al3xand3w0lf/BeeTech/README.md

# BeeTech
 Beehive remote data monitoring

 Still a lot documentation to do:
 - part list, where to buy
 - change solid Works files to STEP, STL files
 - proper project description
 - proper manual
 - ...
