al3xand3w0lf/BeeTech/PROGRAMMING/Beetech ETH/ToDo.md

# To-Do’s

## ~~Recherchieren~~

## Hardware
- 3D-Design
  - ~~Teller~~
  - Gehäuse
- ~~Proto-Typ Aufbau~~

## Software
- ~~OLED ausprobieren~~
- ~~TEMP-Sensor ausprobieren~~
- ~~XFW ausprobieren~~
- ~~Waage konfiguieren~~
- ~~WLAN & InfluxDB einrichten~~
- ~~Code zusammenfügen~~
- Wake-Up funktion
- Daten an Server schicken

## Dokumentation
- Journal
- ~~Zeitplan~~
- GitHub
