al3xand3w0lf/BeeTech/PROGRAMMING/Beetech ETH/Dokumentation/links.md

# Links

- [Temp Sensor](https://www.analog.com/media/en/technical-documentation/data-sheets/ds18b20.pdf)
- [XFW-HX711](https://randomnerdtutorials.com/arduino-load-cell-hx711/)
- [ESP32 Feather V2](https://learn.adafruit.com/adafruit-esp32-feather-v2/overview)
