al3xand3w0lf/BeeTech/PROGRAMMING/Beetech ETH/Dokumentation/ProjektDoku.md

# IoT-Waage -- Projektdokumentation

## Inhaltsverzeichnis

1.  [Einleitung](#1-einleitung)
    -   [Projektauftrag](#11-projektauftrag)
    -   [Zielsetzung](#12-zielsetzung)
    -   [Rahmenbedingungen](#13-rahmenbedingungen)

2.  [Grundlagen & Theorie](#2-grundlagen--theorie)
    - [Wägezellen & HX711](#21-wägezellen--hx711)
    - [ESP32 Grundlagen](#22-esp32-grundlagen)
    - [DS18B20 Grundlagen](#23-ds18b20-grundlagen)
    - [OLED und I²C](#24-oled-und-i²c)
    - [IoT-Architektur (InfluxDB & Grafana)](#25-iot-architektur-influxdb--grafana)

3.  [Anforderungen](#3-anforderungen)
    - [Funktionale Anforderungen](#31-funktionale-anforderungen)
    - [Nicht-funktionale Anforderungen](#32-nicht-funktionale-anforderungen)
    - [Abnahmekriterien](#33-abnahmekriterien)
    - [Risiken & Herausforderungen](#34-risiken--herausforderungen)

4.  [Projektplanung](#4-projektplanung)
    - [Projektstruktur](#41-projektstruktur)
    - [Zeitplan](#42-zeitplan)
    - [Meilensteine](#43-meilensteine)
    - [Aufwandsschätzung](#44-aufwandsschätzung)
    - [Arbeitsmethode](#45-arbeitsmethode)

5.  [Mechanischer Aufbau](#5-mechanischer-aufbau)
    - [Komponenten & Materialien](#51-komponenten--materialien)
    - [Mechanisches Konzept](#52-mechanisches-konzept)
    - [CAD-Modelle](#53-cad-modelle)
    - [Belastungstests](#54-belastungstests)

6.  [Elektronischer Aufbau](#6-elektronischer-aufbau)
    - [Schaltplan](#61-schaltplan)
    - [Pinbelegung](#62-pinbelegung)
    - [Verkabelung](#63-verkabelung)
    - [Stromversorgung](#64-stromversorgung)

7.  [Softwareentwicklung](#7-softwareentwicklung)
    - [Softwarearchitektur](#71-softwarearchitektur)
    - [Kalibrierung](#72-kalibrierung)
    - [Temperaturmessung](#73-temperaturmessung)
    - [OLED-Ausgabe](#74-oled-ausgabe)
    - [WLAN & InfluxDB](#75-wlan--influxdb)
    - [Fehlerhandling](#76-fehlerhandling)

8.  [Inbetriebnahme & Tests](#8-inbetriebnahme--tests)
    - [Einzelkomponententests](#81-einzelkomponententests)
    - [Integrationstests](#82-integrationstests)
    - [Belastungstest](#83-belastungstest)
    - [Genauigkeitsanalyse](#84-genauigkeitsanalyse)

9.  [Ergebnisse & Visualisierung](#9-ergebnisse--visualisierung)
    - [Beispielmessungen](#91-beispielmessungen)
    - [Grafana Screenshots](#92-grafana-screenshots)
    - [Bewertung](#93-bewertung)

10. [Fazit](#10-fazit)
    - [Reflexion](#101-reflexion)
    - [Verbesserungsansätze](#102-verbesserungsansätze)
    - [Ausblick](#103-ausblick)

11. [Anhang](#11-anhang)
    - [Schaltpläne](#111-schaltpläne)
    - [CAD-Zeichnungen](#112-cad-zeichnungen)
    - [Stückliste](#113-stückliste)
    - [Quellcode](#114-quellcode)
    - [Datenblätter](#115-datenblätter)
    - [GitHub-Link](#116-github-link)

------------------------------------------------------------------------

# 1. Einleitung

## 1.1 Projektauftrag

Es soll eine elektronische IoT-Waage gebaut werden, welche periodisch
(alle 60 Sekunden) das Gewicht der Last in kg misst. Zusätzlich soll die
Temperatur der Last gemessen werden. Diese Messwerte sollen auf einem
OLED-Display dargestellt und gleichzeitig via WLAN in eine
InfluxDB-Datenbank gespeichert werden. Die Werte können via GrafanaDB
visualisiert werden. Alles wird auf GitHub veröffentlicht.

## 1.2 Zielsetzung

-   Zuverlässige Gewichtsmessung
-   Temperaturmessung
-   Senden der Daten an InfluxDB
-   Darstellung auf OLED

## 1.3 Rahmenbedingungen

-   Zeitraum: 120h
-   Arbeitsumgebung: Labor
-   Software: Arduino IDE
-   Komponenten: ESP32, HX711, DS18B20
-   Keine Tara-Funktion
-   Interner Gebrauch

------------------------------------------------------------------------

# 2. Grundlagen & Theorie

## 2.1 Wägezellen & HX711

Wägezellen basieren meist auf Dehnungsmessstreifen (DMS), die in einer Wheatstone-Brücke verschaltet sind. Wird die Zelle belastet, verändert sich der elektrische Widerstand der DMS minimal, wodurch eine sehr kleine Spannungsänderung entsteht. Diese Differenzspannung liegt typischerweise im Millivolt-Bereich und muss verstärkt und digitalisiert werden.

Der HX711 ist ein speziell für Wägezellen entwickelter 24-Bit-Analog-Digital-Wandler mit integriertem Verstärker. Er verstärkt die geringe Brückenspannung und wandelt sie in digitale Messwerte um, die seriell über zwei Pins (DOUT und SCK) ausgelesen werden können. Er ermöglicht eine hohe Messauflösung und eignet sich dadurch gut für Präzisionswaagen.

## 2.2 ESP32 Grundlagen

Der ESP32 ist ein Mikrocontroller mit integrierter WLAN- und Bluetooth-Funktionalität und eignet sich daher besonders für IoT-Anwendungen. Er verfügt über eine Vielzahl von GPIOs, unterstützt mehrere Kommunikationsprotokolle wie I²C, SPI, UART und OneWire und bietet ausreichend Rechenleistung für Sensorverarbeitung, Datenübertragung und interne Logik.

Für dieses Projekt übernimmt der ESP32 die Messwerterfassung, die Datenverarbeitung und die Kommunikation mit der Datenbank. Zudem steuert er Peripheriegeräte wie das OLED-Display und den Temperatursensor.

## 2.3 DS18B20 Grundlagen

Der DS18B20 ist ein digitaler Temperatursensor, der über das OneWire-Protokoll kommuniziert. Dieses benötigt nur eine einzige Datenleitung, über die sowohl die Kommunikation als auch die Identifikation erfolgt. Jede DS18B20-Einheit besitzt eine weltweit eindeutige 64-Bit-ID, wodurch mehrere Sensoren auf derselben Leitung betrieben werden können.

Der Sensor liefert Temperaturwerte zwischen −55 °C und +125 °C mit einer typischen Genauigkeit von ±0.5 °C im Bereich um 25 °C. Er kann normal mit drei Leitungen betrieben oder über „Parasite Power“ mit nur zwei Leitungen versorgt werden.

## 2.4 OLED und I²C

OLED-Displays bestehen aus selbstleuchtenden Pixeln und benötigen daher keine Hintergrundbeleuchtung. Typische Module im Embedded-Bereich, wie 128×64-Pixel-Displays, verwenden den I²C-Bus zur Kommunikation. I²C arbeitet mit zwei Leitungen (SDA und SCL) und ermöglicht das parallele Betreiben mehrerer Geräte am selben Bus, die jeweils über eine eindeutige Adresse angesprochen werden.

Im Projekt dient das OLED-Display zur visuellen Ausgabe der Gewichtswerte und Statusinformationen. Durch die geringe Leistungsaufnahme und die einfache Ansteuerung eignet es sich gut für kompakte IoT-Systeme.

## 2.5 IoT-Architektur (InfluxDB & Grafana)

Für die Speicherung und Visualisierung der Messdaten wird eine IoT-Architektur verwendet, die auf einer Zeitreihendatenbank basiert. Der ESP32 übermittelt die erfassten Werte über WLAN an eine InfluxDB-Instanz. InfluxDB ist optimiert für zeitbasierte Daten und erlaubt effizientes Speichern, Abfragen und Verarbeiten von Messreihen.

Zur Darstellung der Daten wird Grafana eingesetzt. Grafana ermöglicht das Erstellen interaktiver Dashboards, in denen Gewichtswerte, Temperaturverläufe und weitere Parameter übersichtlich visualisiert werden können. Die Kombination aus InfluxDB und Grafana bildet damit eine robuste Grundlage für die Analyse und Überwachung des Systems.

------------------------------------------------------------------------

# 3. Anforderungen

## 3.1 Funktionale Anforderungen

Die elektronische IoT-Waage muss folgende funktionale Anforderungen erfüllen:

- Die Waage misst das **Gesamtgewicht** einer aufgelegten Last mittels **vier Wägezellen**.
- Der **Messbereich** der Waage beträgt **0 bis 100 kg**.
- Die Gewichtsmessung erfolgt **periodisch alle 60 Sekunden**.
- Zusätzlich wird die **Temperatur der Last** mit einem digitalen Temperatursensor gemessen.
- Die aktuellen Messwerte (**Gewicht in kg, Temperatur in °C**) werden auf einem **OLED-Display** angezeigt.
- Die Messwerte werden **drahtlos über WLAN** an eine **InfluxDB-Datenbank** übertragen.
- Die gespeicherten Daten können in **Grafana** als Zeitreihe visualisiert werden.
- Die Waage verfügt über eine **Software-Kalibrierfunktion**.
- Die Messung bleibt auch bei **ungleicher Lastverteilung** funktionsfähig.
- Die Software läuft auf einem **ESP32-Mikrocontroller** und startet nach dem Einschalten automatisch.

## 3.2 Nicht-funktionale Anforderungen

Neben der reinen Funktionalität gelten folgende nicht-funktionale Anforderungen:

- Die Gewichtsanzeige ist **stabil** und zeigt im Ruhezustand keine stark schwankenden Werte.
- Die Messwerte werden **nachvollziehbar und reproduzierbar** erfasst.
- Die Software ist **strukturiert**, modular aufgebaut und ausreichend **kommentiert**.
- Alle Schaltpläne werden **übersichtlich und normgerecht** in **KiCad** erstellt.
- Mechanische Bauteile werden **sauber konstruiert** und **passgenau** gefertigt.
- Die Dokumentation ist **vollständig**, **verständlich** und **technisch korrekt**.
- Der gesamte Entwicklungsprozess wird mit **Git** versioniert.
- Die Messdatenübertragung ist **robust** gegenüber kurzen WLAN-Unterbrüchen.
- Die Stromversorgung erfolgt sicher über **USB 5 V**.
- Es werden ausschliesslich **frei verfügbare oder lizenzierte Bibliotheken** verwendet.

## 3.3 Abnahmekriterien

Das Projekt gilt als erfolgreich abgeschlossen, wenn folgende Kriterien erfüllt sind:

- Die Waage zeigt bei bekannten Prüfgewichten **plausible und reproduzierbare Messergebnisse**.
- Gewicht und Temperatur werden **korrekt auf dem OLED-Display** dargestellt.
- Messwerte werden **regelmässig in der InfluxDB gespeichert**.
- Die Messdaten sind in **Grafana** visualisierbar.
- Die Kalibrierung ist **dokumentiert** und nachvollziehbar.
- Der Schaltplan ist vollständig und entspricht dem realen Aufbau.
- Die mechanischen Bauteile erfüllen ihre Funktion ohne Beschädigung.
- Die Software lässt sich **kompilieren, flashen und starten**.
- Der gesamte Projektcode ist im **GitHub-Repository** vorhanden.
- Die Dokumentation deckt alle geforderten Kapitel ab.

## 3.4 Risiken & Herausforderungen

Während der Projektumsetzung bestehen folgende Risiken und Herausforderungen:

- **Ungleichmässige Lastverteilung** kann zu Messabweichungen führen.
- **Mechanische Toleranzen** im 3D-Druck können die Genauigkeit beeinflussen.
- **Temperaturdrift** der Wägezellen kann Messwerte verfälschen.
- **Elektrisches Rauschen** kann die Messung des HX711 beeinträchtigen.
- **Kalibrierung** mehrerer Wägezellen erfordert erhöhte Sorgfalt.
- **WLAN-Verbindungsprobleme** können zu Datenverlust führen.
- **Zeitmanagement** bei paralleler Hard- und Softwareentwicklung.
- **Fehlende Erfahrung** mit bestimmten Messverfahren kann Mehraufwand verursachen.

------------------------------------------------------------------------

# 4. Projektplanung

## 4.1 Projektstruktur

Um das Projekt übersichtlich und gut planbar zu machen, habe ich es in mehrere Hauptbereiche aufgeteilt. Jeder Bereich deckt einen bestimmten Teil der Arbeit ab, und zusammen ergeben sie das komplette IoT-Waagen-System. Durch diese Struktur konnte ich Schritt für Schritt arbeiten, ohne den Überblick zu verlieren.

Die Projektstruktur besteht aus folgenden Teilen:

- **Mechanik:**  
  Aufbau der Waage mit vier Wägezellen und zwei Metallplatten. Dazu gehört das Positionieren der Elemente, die Stabilität der Konstruktion und das Erstellen von CAD-Modellen in SolidWorks.

- **Elektronik:**  
  Verdrahten und Anschliessen aller Komponenten (ESP32, HX711, DS18B20, OLED). Auch die Pinbelegung, Stromversorgung und der Schaltplan in KiCad gehören in diesen Bereich.

- **Software:**  
  Programmierung des ESP32 mit der Arduino IDE. Dazu zählen das Auslesen der Wägezellen, die Kalibrierung, die Temperaturmessung, die Anzeige auf dem OLED und das Senden der Daten an die InfluxDB.

- **Tests & Kalibrierung:**  
  Überprüfen der einzelnen Module, Belastungstests, Genauigkeitsmessungen und die Kalibrierung der Waage mit Referenzgewichten. Hier wird geschaut, ob die Waage zuverlässig arbeitet.

- **Datenanbindung (InfluxDB & Grafana):**  
  Einrichten der Verbindung zur Datenbank, Testen der Übertragung und Kontrolle der Messwerte in Grafana. So wird sichtbar, wie sich die Werte über die Zeit verändern.

- **Dokumentation & Journal:**  
  Schreiben der Projektunterlagen, Festhalten des täglichen Arbeitsfortschritts im Journal und Erstellen des GitHub-Repositories. Dadurch bleibt das Projekt vollständig nachvollziehbar.

Diese Struktur hilft dabei, das Projekt sauber zu gliedern und jeden Teil separat behandeln zu können. Wenn irgendwo ein Problem auftaucht, kann ich dank dieser Aufteilung schnell erkennen, in welchem Bereich es entsteht und wie ich es am besten angehe.

## 4.2 Zeitplan

## 4.3 Meilensteine

## 4.4 Aufwandsschätzung

## 4.5 Arbeitsmethode

Für dieses Projekt habe ich versucht, möglichst strukturiert und Schritt für Schritt zu arbeiten. Damit ich den Überblick behalte, habe ich das Projekt in mehrere Bereiche eingeteilt: Mechanik, Elektronik, Software, Tests und Dokumentation. So konnte ich mich immer auf einen Teil konzentrieren, ohne alles gleichzeitig machen zu müssen.

Ich habe ein GitHub-Repository erstellt, in dem ich meinen Code und wichtige Dateien gespeichert habe. Dadurch konnte ich Änderungen sauber festhalten und jederzeit auf ältere Versionen zurückgreifen. Für den Schaltplan habe ich KiCad verwendet und die mechanischen Teile mit SolidWorks modelliert. Programmiert wurde alles in der Arduino IDE, weil ich damit am schnellsten vorankomme.

Beim Arbeiten bin ich nach dem Prinzip vorgegangen, zuerst jede Komponente einzeln zu testen. Also z. B. zuerst den HX711, dann den Temperatursensor, dann das OLED. Wenn etwas nicht funktioniert hat, konnte ich so viel einfacher herausfinden, wo der Fehler liegt. Erst als alle Module einzeln liefen, habe ich sie zusammengebaut und weiter getestet.

Während des gesamten Projekts habe ich ein tägliches Journal geführt, in dem ich festgehalten habe, was ich gemacht habe, welche Probleme aufgetaucht sind und wie ich sie gelöst habe. Das hilft nicht nur für die Doku, sondern auch, um später nachzuvollziehen, warum ich etwas auf eine bestimmte Art gemacht habe.

Die Dokumentation habe ich parallel zum Projekt geschrieben und am Schluss nochmals alles sauber zusammengestellt.

Diese Arbeitsweise hat mir geholfen, das Projekt klar zu strukturieren und Probleme schnell zu erkennen und zu lösen.

------------------------------------------------------------------------

# 5. Mechanischer Aufbau

## 5.1 Komponenten & Materialien

## 5.2 Mechanisches Konzept

## 5.3 CAD-Modelle

## 5.4 Belastungstests

------------------------------------------------------------------------

# 6. Elektronischer Aufbau

## 6.1 Schaltplan

## 6.2 Pinbelegung

## 6.3 Verkabelung

## 6.4 Stromversorgung

------------------------------------------------------------------------

# 7. Softwareentwicklung

## 7.1 Softwarearchitektur

## 7.2 Kalibrierung

## 7.3 Temperaturmessung

## 7.4 OLED-Ausgabe

## 7.5 WLAN & InfluxDB

## 7.6 Fehlerhandling

------------------------------------------------------------------------

# 8. Inbetriebnahme & Tests

## 8.1 Einzelkomponententests

## 8.2 Integrationstests

## 8.3 Belastungstest

## 8.4 Genauigkeitsanalyse

------------------------------------------------------------------------

# 9. Ergebnisse & Visualisierung

## 9.1 Beispielmessungen

## 9.2 Grafana Screenshots

## 9.3 Bewertung

------------------------------------------------------------------------

# 10. Fazit

## 10.1 Reflexion

## 10.2 Verbesserungsansätze

## 10.3 Ausblick

------------------------------------------------------------------------

# 11. Anhang

## 11.1 Schaltpläne

## 11.2 CAD-Zeichnungen

## 11.3 Stückliste

## 11.4 Quellcode

## 11.5 Datenblätter

## 11.6 GitHub-Link
