al3xand3w0lf/BeeTech/ELECTRONIC_CAD/voltageLevelsNanoBoard.docx

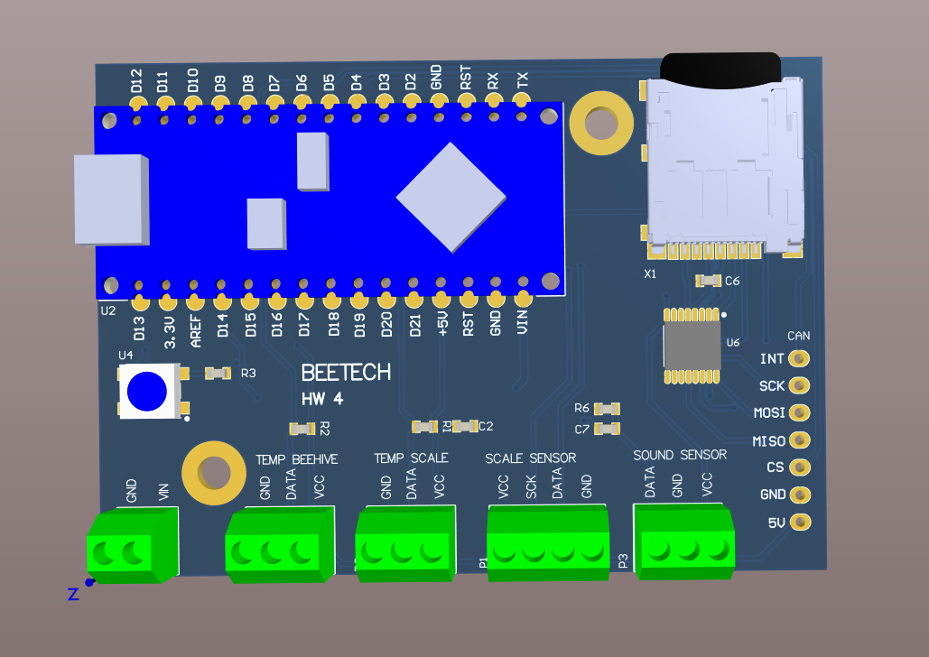
[picture p3: figure]

+12V

+5v

+5v

+5v

+5v

+5v

+3.3v

+5v
