al3xand3w0lf/BeeTech/PROGRAMMING/Beetech ETH/Dokumentation/zeitplan_tabelle.md

# Zeitplan

## Meilensteine

| Aufgabe | Geschätzte Zeit (Stunden) | Ist Zeit (Stunden) | Bemerkungen | Soll Beendet | Ist Beendet |
|---|---|---|---|---|---|
| Recherche & Verständnis | 6–10 |  8 | Verstehen von HX711, ESP32, OneWire, OLED | 3.12 | 3.12. |
| Projektplanung | 3–5 |  3 | Grundstruktur & Meilensteine erstellen | 3.12 | 3.12. |
| CAD-Design (SolidWorks + 3D-Druck) | 10–15 | | Modellierung + Druck + Anpassungen | 16.1 | |
| Schaltplan (KiCad) | 6–10 | | Sauberer Schaltplan mit Labels | 19.12 | |
| Stückliste (BOM) | 2–3 | | Bauteile, Preise, Bestellnummern | 19.12 | |
| Hardware-Aufbau | 8–12 | | Mechanischer & elektrischer Aufbau | 9.12 | |
| Software Basis-Funktionalität | 8–12 | | Sensoren + Display ansteuern | 12.12 | |
| Protokollanalyse | 4–6 | | I2C analysieren, Screenshots | 14.12 | |
| Kalibrierung der Waage | 3–4 | | Gewichte testen & Faktoren bestimmen | 12.1 | |
| WLAN + InfluxDB-Integration | 6–10 | | Datenbank-Anbindung & Senden | 12.12 | |
| Dokumentation (Word) | 15–20 | | Screenshots, Erklärungen, Struktur | 23.1 | |
| GitHub-Aufbereitung | 2–4 | | Repository aufräumen, README | 25.1 | |

---

## Soll

| Tag | KW49 | KW50 | KW51 | KW2 | KW3 | KW4 |
|---|---|---|---|---|---|---|
| Montag | Recherche | Teller Designen | WLAN InfluxDB  | Doku | 3D-Design  | Testen  |
| Mittwoch  | GitHub erweitern | Waage konfigurieren | Schematic | x | 3D-Design  | Doku |
| Donnerstag| OLED Code schreiben| Doku | Schematic | Doku | 3D-Design  | Doku |
| Freitag | Temp testen | Prototyp Aufbau | Schematic | Doku | Testen | Doku |

---

## Ist

| Tag | KW49 | KW50 | KW51 | KW2 | KW3 | KW4 |
|---|---|---|---|-----|-----|-----|
| Montag | Rechechiert | Teller am Designen | | | | |
| Mittwoch  | GitHub erweitert | Doku weitergeschreiben | | | | |
| Donnerstag| OLED Code geschrieben | Teller Designet | | | | |
| Freitag | Temp getestet | Waage am Konfiguiren | | | | |
