al3xand3w0lf/BeeTech/ELECTRONIC_CAD/ECAD/Scale Board.docx

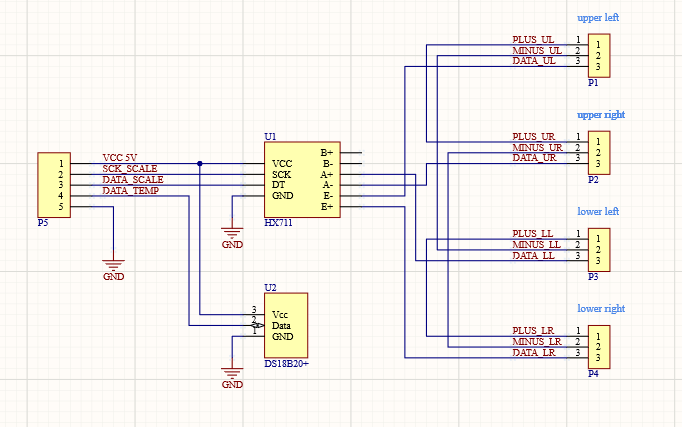
[picture p4: figure]
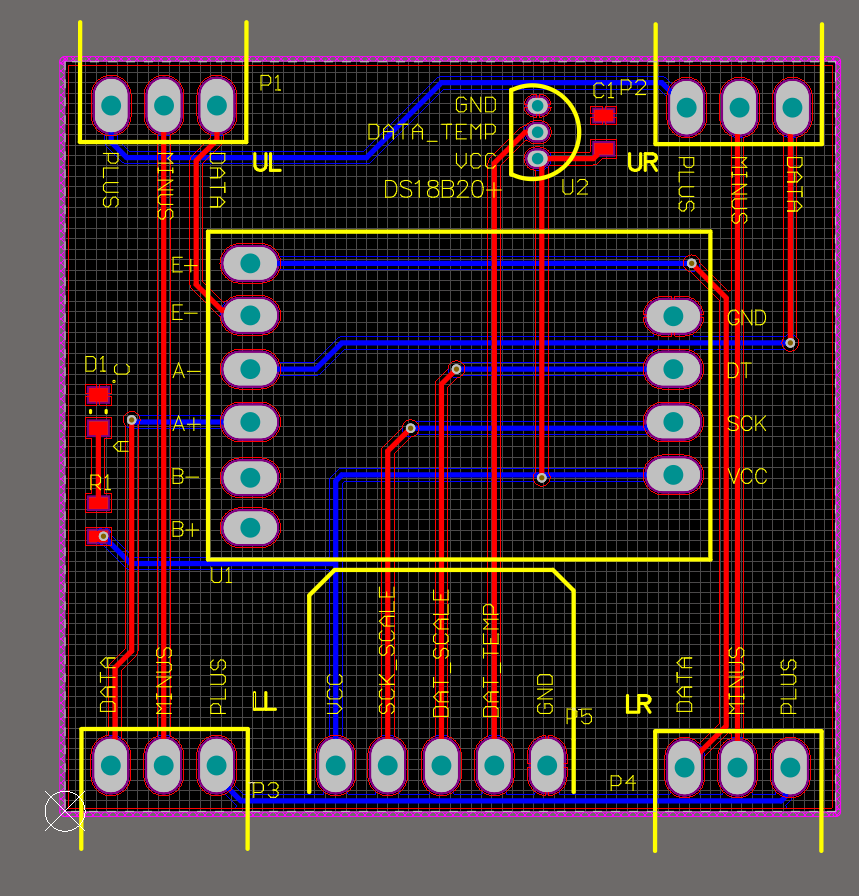
[picture p5: figure]
