al3xand3w0lf/BeeTech/PROGRAMMING/Beetech V1/BeeHive_MKR1400_Board/canScematic.pdf

X_
x

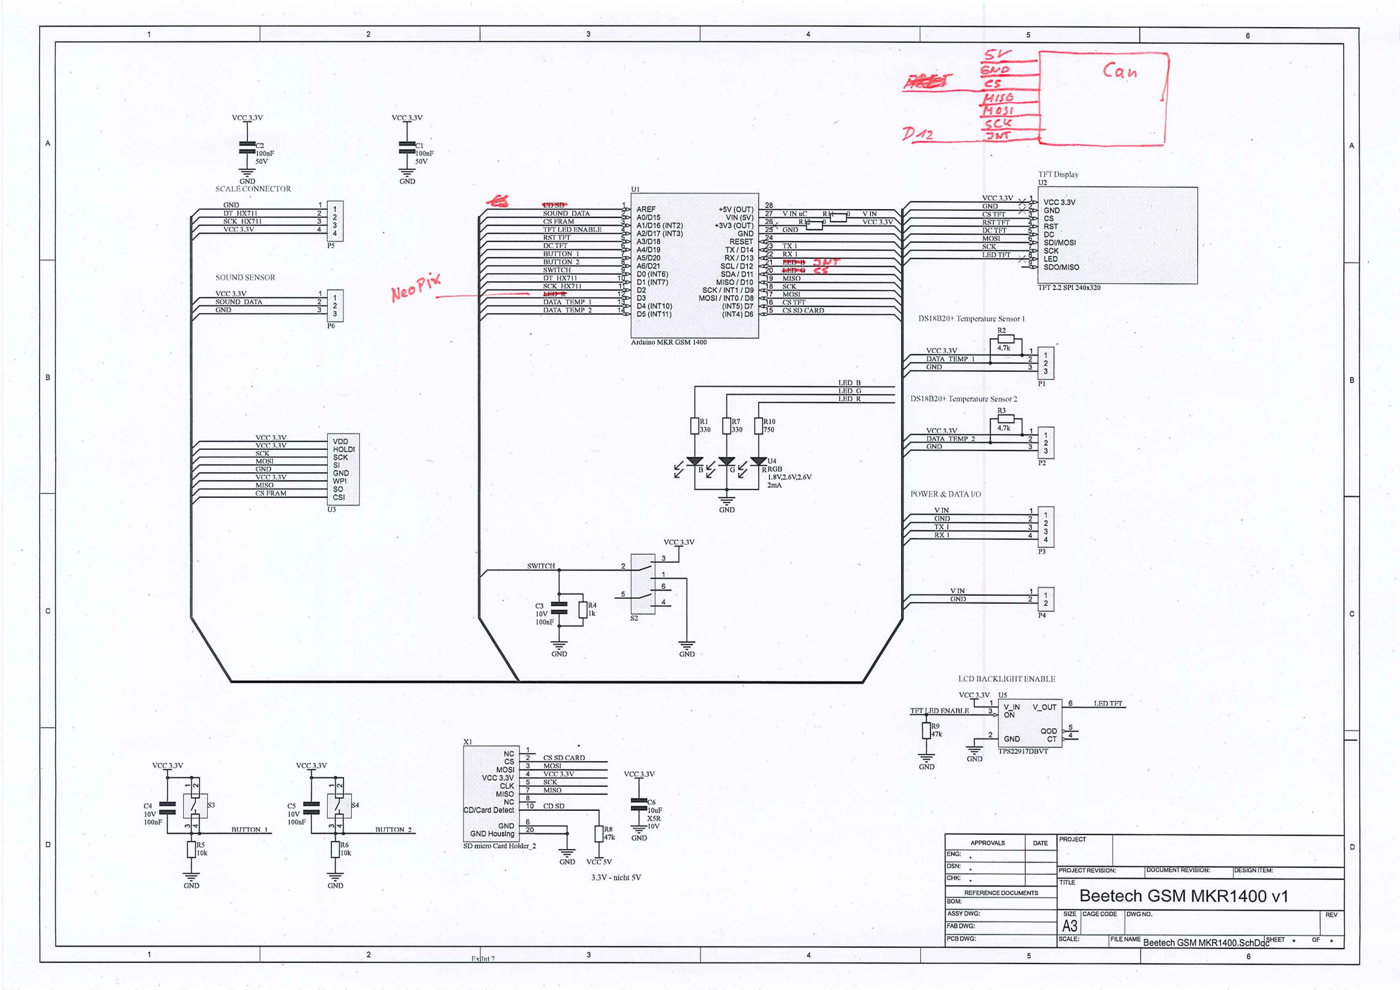
[picture p6: page 1]

VCC 3.3V

### GND

DT HX711
SCK HX71I
VC'C 3.3V

3:

MH'NDSl'NSOR

VCC 3.3V
SOUND DATA
GND

1
2
3

### VDD HOLDI SCK

VCC -•UV

"L

'lOOn
50V

-<^

^'^
^"•:

SOUND DATA

TFl'LKD UNABLE

DATA TKMK 1
DATA •t'KMl1 ;

# ^iki

^

TH- Display
U2

### +5V (OUT) VIN (5V) +3V3 (OUT) GND

# JSSET [^

### TX/D14 h^ RX/D13 SCL/012 SDA/D11 MISO/D10 SCK/INT1/D9 MOSI/INTO/D8 (1NT5) D7 (INT4) D6

Arduiiio MKR GSM 1400

^

^

### iiii nit7 riRio

|330 | |330 | |750

### ttRQB

1.8V.2.6V.2.GV
2mA

VCC 3.3V

### GND

os

### RST

DC

### SDl/MOSI SCK LED SDO/MISO

TFT 2.2 SPI 240x320

VCC.3
DATA
ON D

.3V
TEMP 1
4.7k | 1
| _2_ _3

vmPATA_
JV
TF.MP 2

4,7k 1

-2.
3

### POWl-^ADATM/O

V IN
OND

### TXI

RXI

1

_2.
3'
4

NC

### MOSI

VCC 3.3V

### CLK M ISO

NC

### 30/Card Detect GND GND Housing

>D micro Card He

1T3

4
5
7

10

6

-20.
icr 2

CS SD CARD
MOS1
vrr 33V
SCK
Ml SO

CDSD

### IRB

j47k

VCC 3.3V
X.

'10uF
X5R
—i—inv

GND VCC 5V

3,3V - n

l.l.'DI.IAC-t;

VCC 3,3V
1
TFT^RD ENABLE -3^
]1>9

^ ^GND

.id n

15

### V IN

ON

### GND

-!1S229

'iwjiu-:

V_OUT

### QOD

CT
17DBVT

6 LHDTFT

3:

REFERENCE DOCUMEhfTS

IECT REVISION; —I bocUuEN I teUBK»k —U-alGrilltM:

# Beetech GSM MKR1400 v1

A3

### ISCALE I FILE N«UE g^jg^ QSM MKR1400.SchDcigHEET
