al3xand3w0lf/BeeTech/PROGRAMMING/Beetech V1/BeeHive_NanoEvery_Board/can_scematic.pdf

# ZA ^8A3 oue|\| qoeieeg

T^~

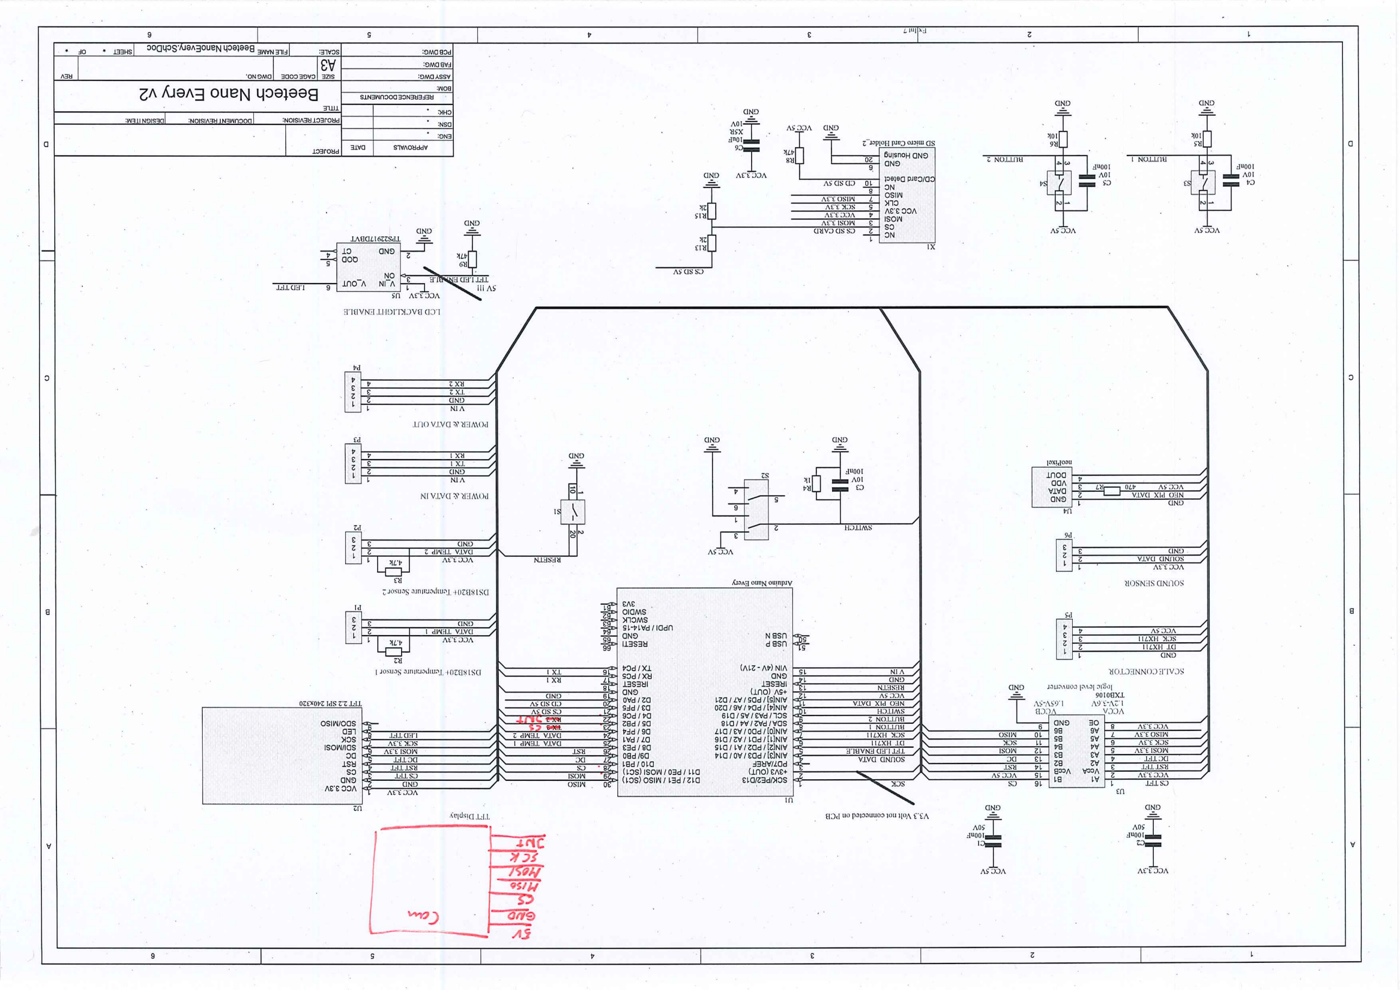
[picture p7: page 1]

A3y

„ . ^Hsl °°a^S''U8A30UENq3S)93g3n,,3,,

•ONOMOl 3aD333V3

:3~]VOS
£Vazis

31111
miiffins-iai :No|R|ft3yiN3nnnog| _:NOisiA3yi33royd

isaroyd

:3Ma93d
:OMQSVd
:OMQASSV

•WOQ
SlN3fin30a 33N3y3d3y

31VQ

:3N3
SIWOUddV

fr
s

jjiua-i 9

lAya^t
10

### aoo

ino-A

6KScL

### ONS

### NFA

if

UNO

^a'n

I
An- JJA

wr
6t!l

i-d ua-i IAI

### Ill AS

•rKiVN-u.nnnxmKL

t?

_E_
3_
I.

ZXtl
ZX.1.

-UM'J..
N1A

ocptoM: ids r^ iji

### osiwoas

031

### xos iscm/ias

oa

### isa

S3
ON9
A£'£ 03A

K)V.LVCIVil;lA\l)d
3: 3:
x

1 XII
1 Xl
UND

Nlv,i.V(iyy;iA\oj

### L-iTti.^'wi:

\-_?-_dMai_viyy_

•i^'.y -~

nsx
d"OIi

QND AE't^DA 1.

it

AS" D3A QW
<

D

M-aticu

AE-EnSltM
AE'E ?tJS
AFE J.JA
AE't- IKCm
uyvj us S3

t "F

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
OH pjco ojaiui as
BufsnoH ON9
QN9

pei&a pjeo/ac)
ON

### osm

>no
AC'E 03A

### ISO N

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
d"OOI
AOI
£3

HJIIAU;

toAg ounft oumpJV

### EAE OIQMS

X-IOAAS
si-nvd/iadn

### ONS iiassy

### >Od/Xi sod/xu iasaai QNS ovd / za Sdd / EQ 90d / ra zad / sa Md/9Q

i.vd / za
£3d / 9G

### OSd ,60

LBd/01.0

### U3S)lSOW/03d/Ll,a (l.OS)OSIM/l3d/21.a

(AI-Z-A^NIA

### QNS lasayi dno) AS+ iza/zv/sad/tslNiv oza/9v/trad/[tr]Niv 6i.a/sv/evd/i3s sia/mzvd/vas ZLa/ev/oad/toNv 9La/W/l.ad/[L]NIV SLQ/LV/Sad/klNIV Ha/ov/ead/t&lNiv jayvuad dno) EAe+ ei.a/zadfflos

V1VCI XIJ OdN

a'lyvM-dua'ii^i
V1VQ QNTIOS
ff-

### inoa aoA viva

QN3

v
E H

z_
L

0^t' A^J^A
V.I.VC1 Xiti UHN
UNO

Al;'E33A

tIOSN.-t^i CIMllOS

e
~z

I.

Ai DJA
IUXH ^js

IUXH 1U ._,_^
QMD

OKIW
^QS;
1SOM
oa
ISll
Ai JJA

^_
_OJ
Sl
£'
fl
51

mt,I.JHNis[(U:-l

90IOBXJL
A')t-.\:ll
,.UA
9

i.

_9_
fr
E
z

Ai:'EO:lA
At'EOyiM
A'i'i •XJS
Ai'i [SON

Idl'JQ .._.,_..,
.L-I-LIS^
M'i DJA

\w
ooii

\os

ooti I
