al3xand3w0lf/BeeTech/PROGRAMMING/Beetech V2/Screenshot 2026-03-02 213556.png

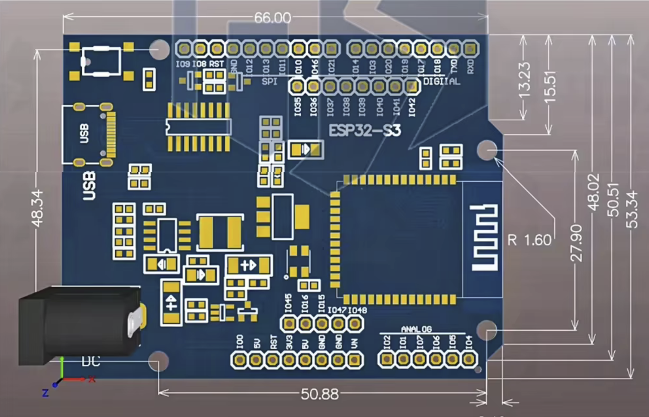
PROGRAMMING/Beetech V2/Screenshot 2026-03-02 213556.png
