al3xand3w0lf/BeeTech/ELECTRONIC_CAD/ECAD/Beetech Metro Shield 1.2/MCAD/PCB.STEP

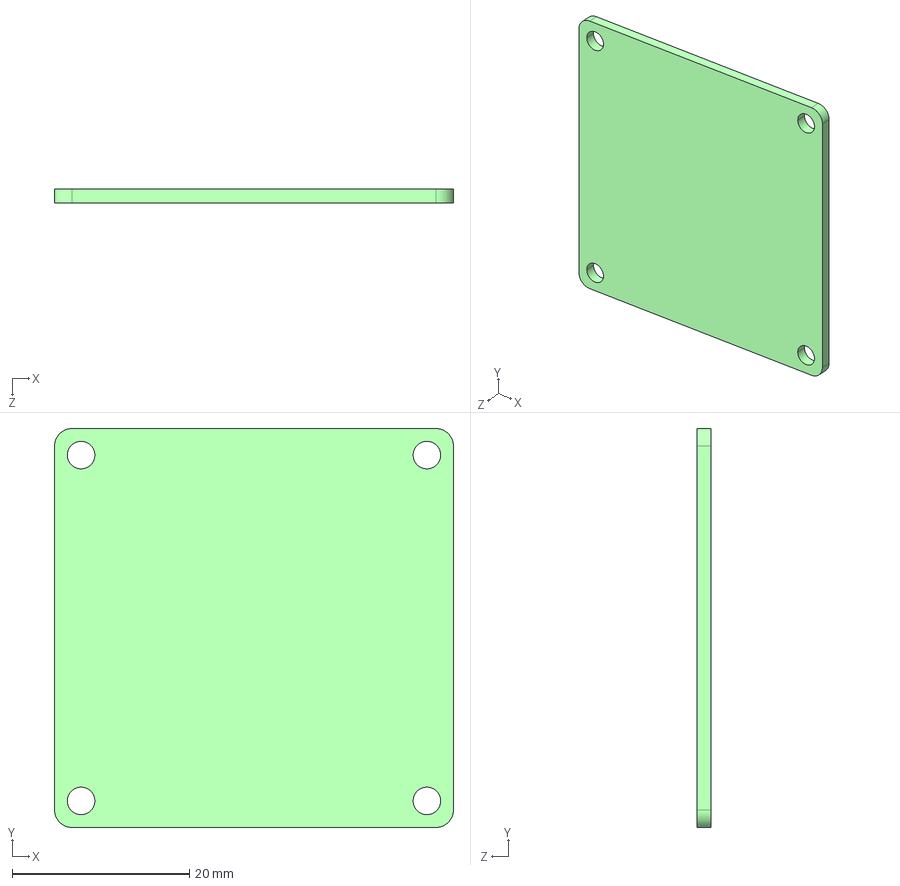
[picture p22: CAD file, 2026-02-08]
ELECTRONIC_CAD/ECAD/Beetech Metro Shield 1.2/MCAD/PCB.STEP
45.0 x 45.0 x 1.60 mm
