al3xand3w0lf/BeeTech/MECHANIC_CAD/waegezelle halter.STEP

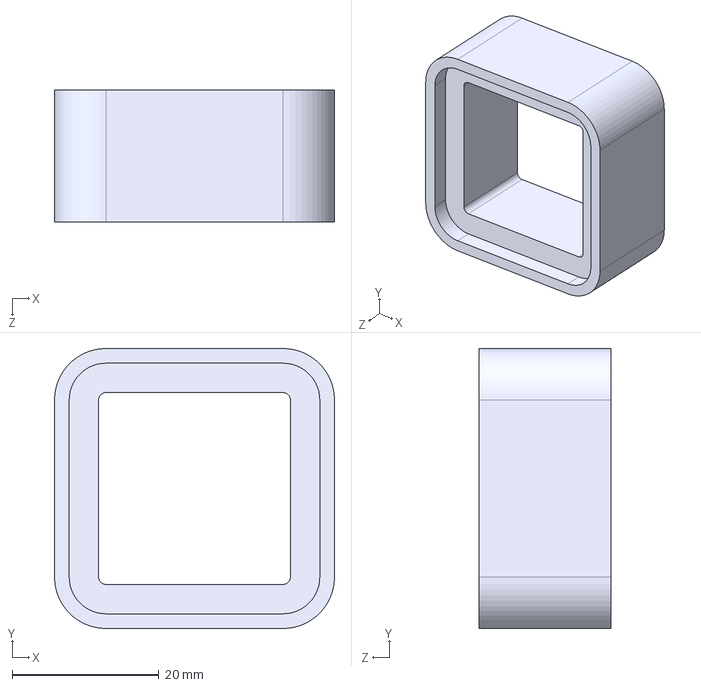
[picture p23: CAD file, 2026-03-04]
MECHANIC_CAD/waegezelle halter.STEP
38.1 x 38.1 x 18.0 mm
