al3xand3w0lf/BeeTech/ELECTRONIC_CAD/ECAD/Beetech Metro Shield 1.2/MCAD/uBlox ZED F9P Miratlas.step

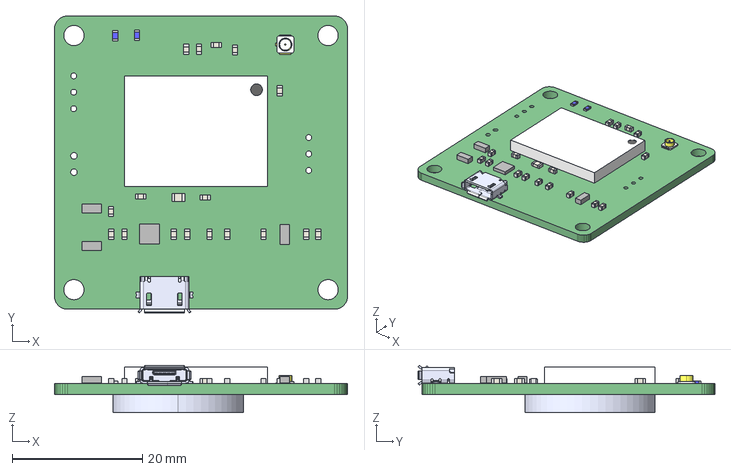
[picture p24: CAD file, 2026-02-08]
ELECTRONIC_CAD/ECAD/Beetech Metro Shield 1.2/MCAD/uBlox ZED F9P Miratlas.step
45.0 x 45.6 x 7.28 mm
