al3xand3w0lf/BeeTech/MECHANIC_CAD/LCD Display 1,37 Zoll 1,37 Zoll Matrix LCD-Modul SPI-Schnittstelle AiP31567.SLDPRT

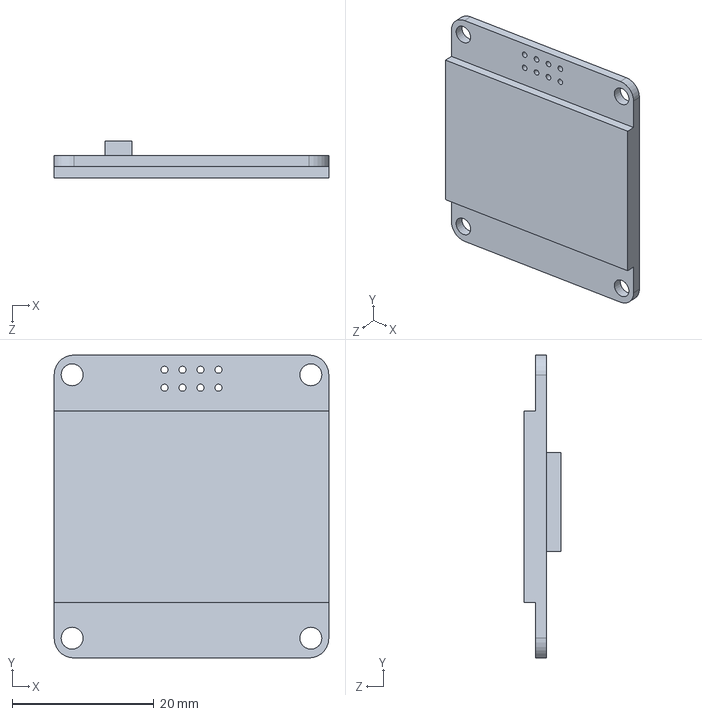
[picture p25: CAD file, 2026-03-01]
MECHANIC_CAD/LCD Display 1,37 Zoll 1,37 Zoll Matrix LCD-Modul SPI-Schnittstelle AiP31567.SLDPRT
38.8 x 42.8 x 5.20 mm
