al3xand3w0lf/BeeTech/ELECTRONIC_CAD/ECAD/Beetech Metro Shield 1.2/MCAD/PCB Arduino.STEP

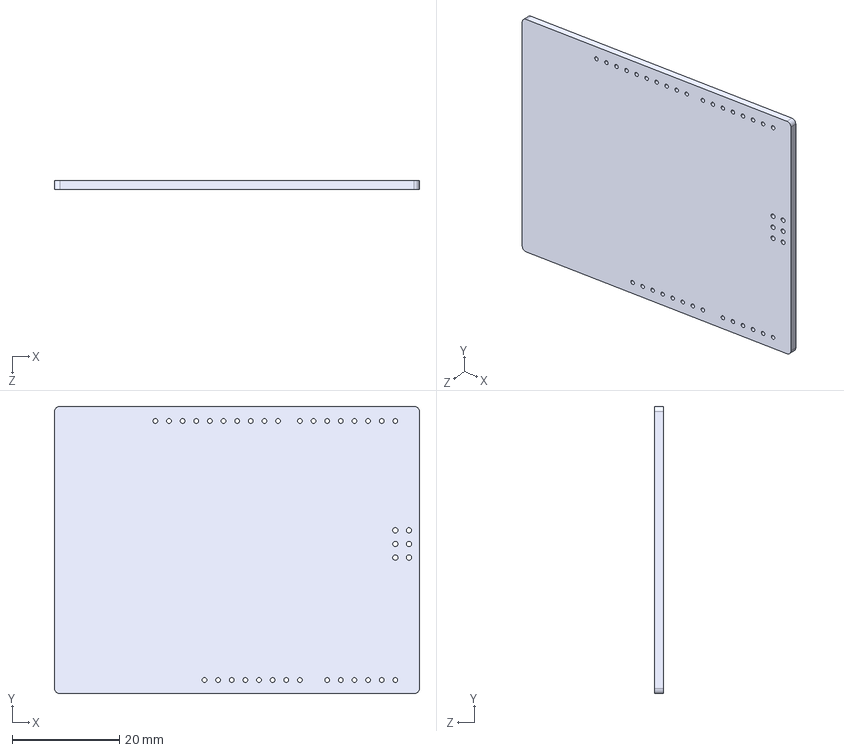
[picture p26: CAD file, 2026-02-08]
ELECTRONIC_CAD/ECAD/Beetech Metro Shield 1.2/MCAD/PCB Arduino.STEP
68.0 x 53.5 x 1.60 mm
