al3xand3w0lf/BeeTech/MECHANIC_CAD/LoadCellFrame2.STEP

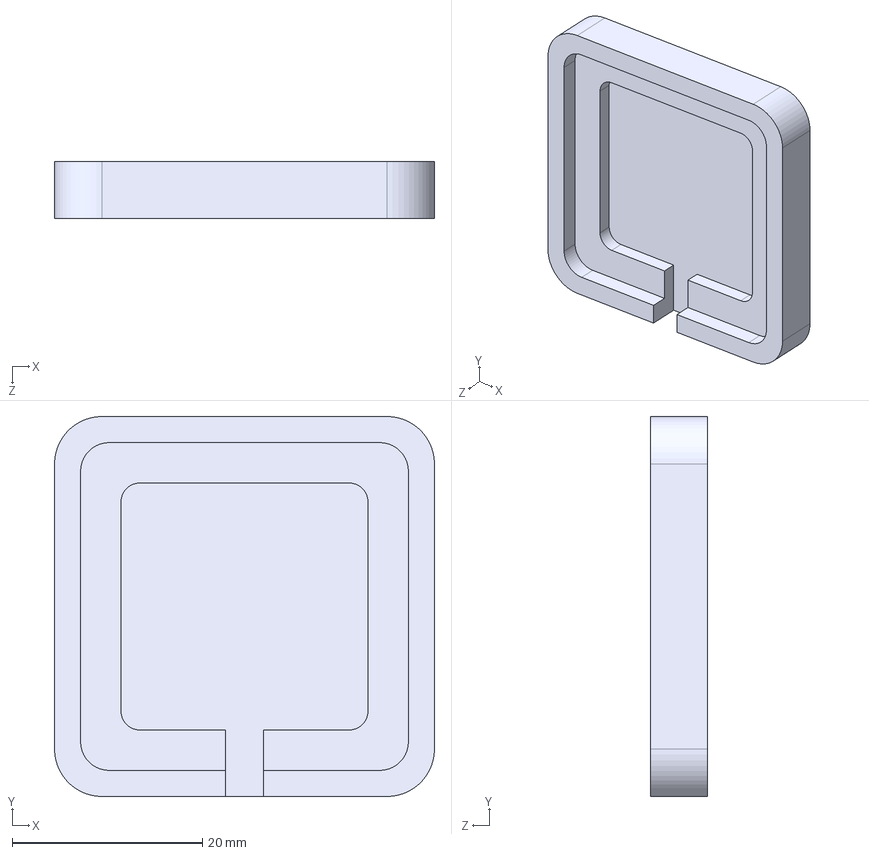
[picture p27: CAD file, 2025-02-28]
MECHANIC_CAD/LoadCellFrame2.STEP
40.0 x 40.0 x 6.00 mm
