al3xand3w0lf/BeeTech/MECHANIC_CAD/Antenna_.SLDPRT

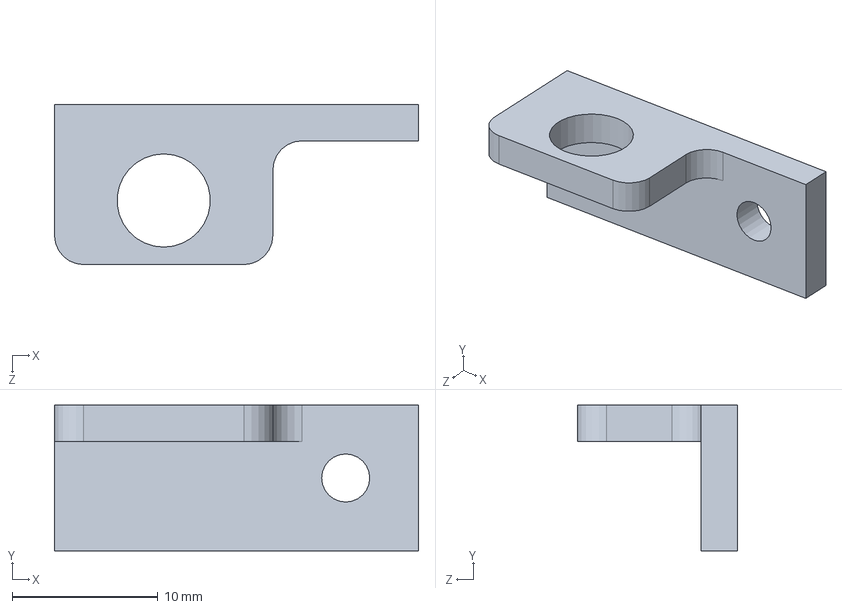
[picture p28: CAD file, 2025-02-28]
MECHANIC_CAD/Antenna_.SLDPRT
25.0 x 10.0 x 11.0 mm
