al3xand3w0lf/BeeTech/MECHANIC_CAD/LED_RGB_Bulp.SLDPRT

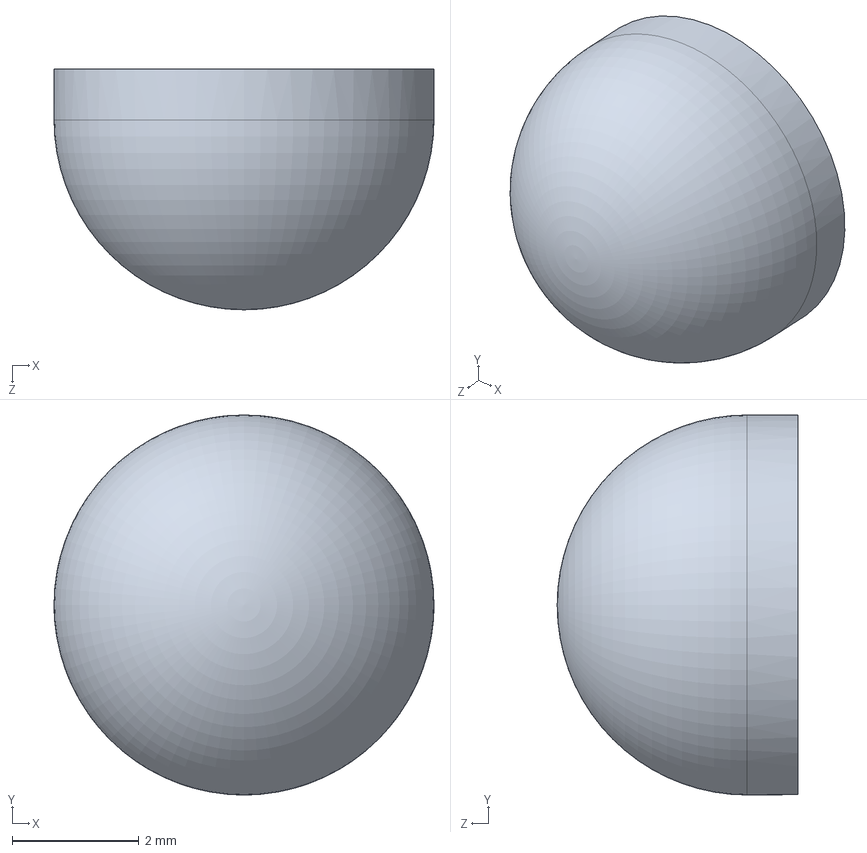
[picture p29: CAD file, 2025-02-28]
MECHANIC_CAD/LED_RGB_Bulp.SLDPRT
6.00 x 6.00 x 3.80 mm
