al3xand3w0lf/BeeTech/(list of files, cad)

Other CAD files:
MECHANIC_CAD/LoadCellFrame.SLDPRT
ELECTRONIC_CAD/ECAD/Beetech Metro Shield 1.2/MCAD/PCB Arduino.SLDPRT
ELECTRONIC_CAD/ECAD/Beetech Metro Shield 1.2/MCAD/PCB.SLDPRT
MECHANIC_CAD/LoadCellFrame2.SLDPRT
MECHANIC_CAD/LoadCellFrame2.STL
MECHANIC_CAD/waegezelle halter.3mf
MECHANIC_CAD/waegezelle halter.SLDPRT
