al3xand3w0lf/BeeTech/ELECTRONIC_CAD/ECAD/Beetech Metro Shield 1.2/Beetech Metro Shield 1.1.pdf

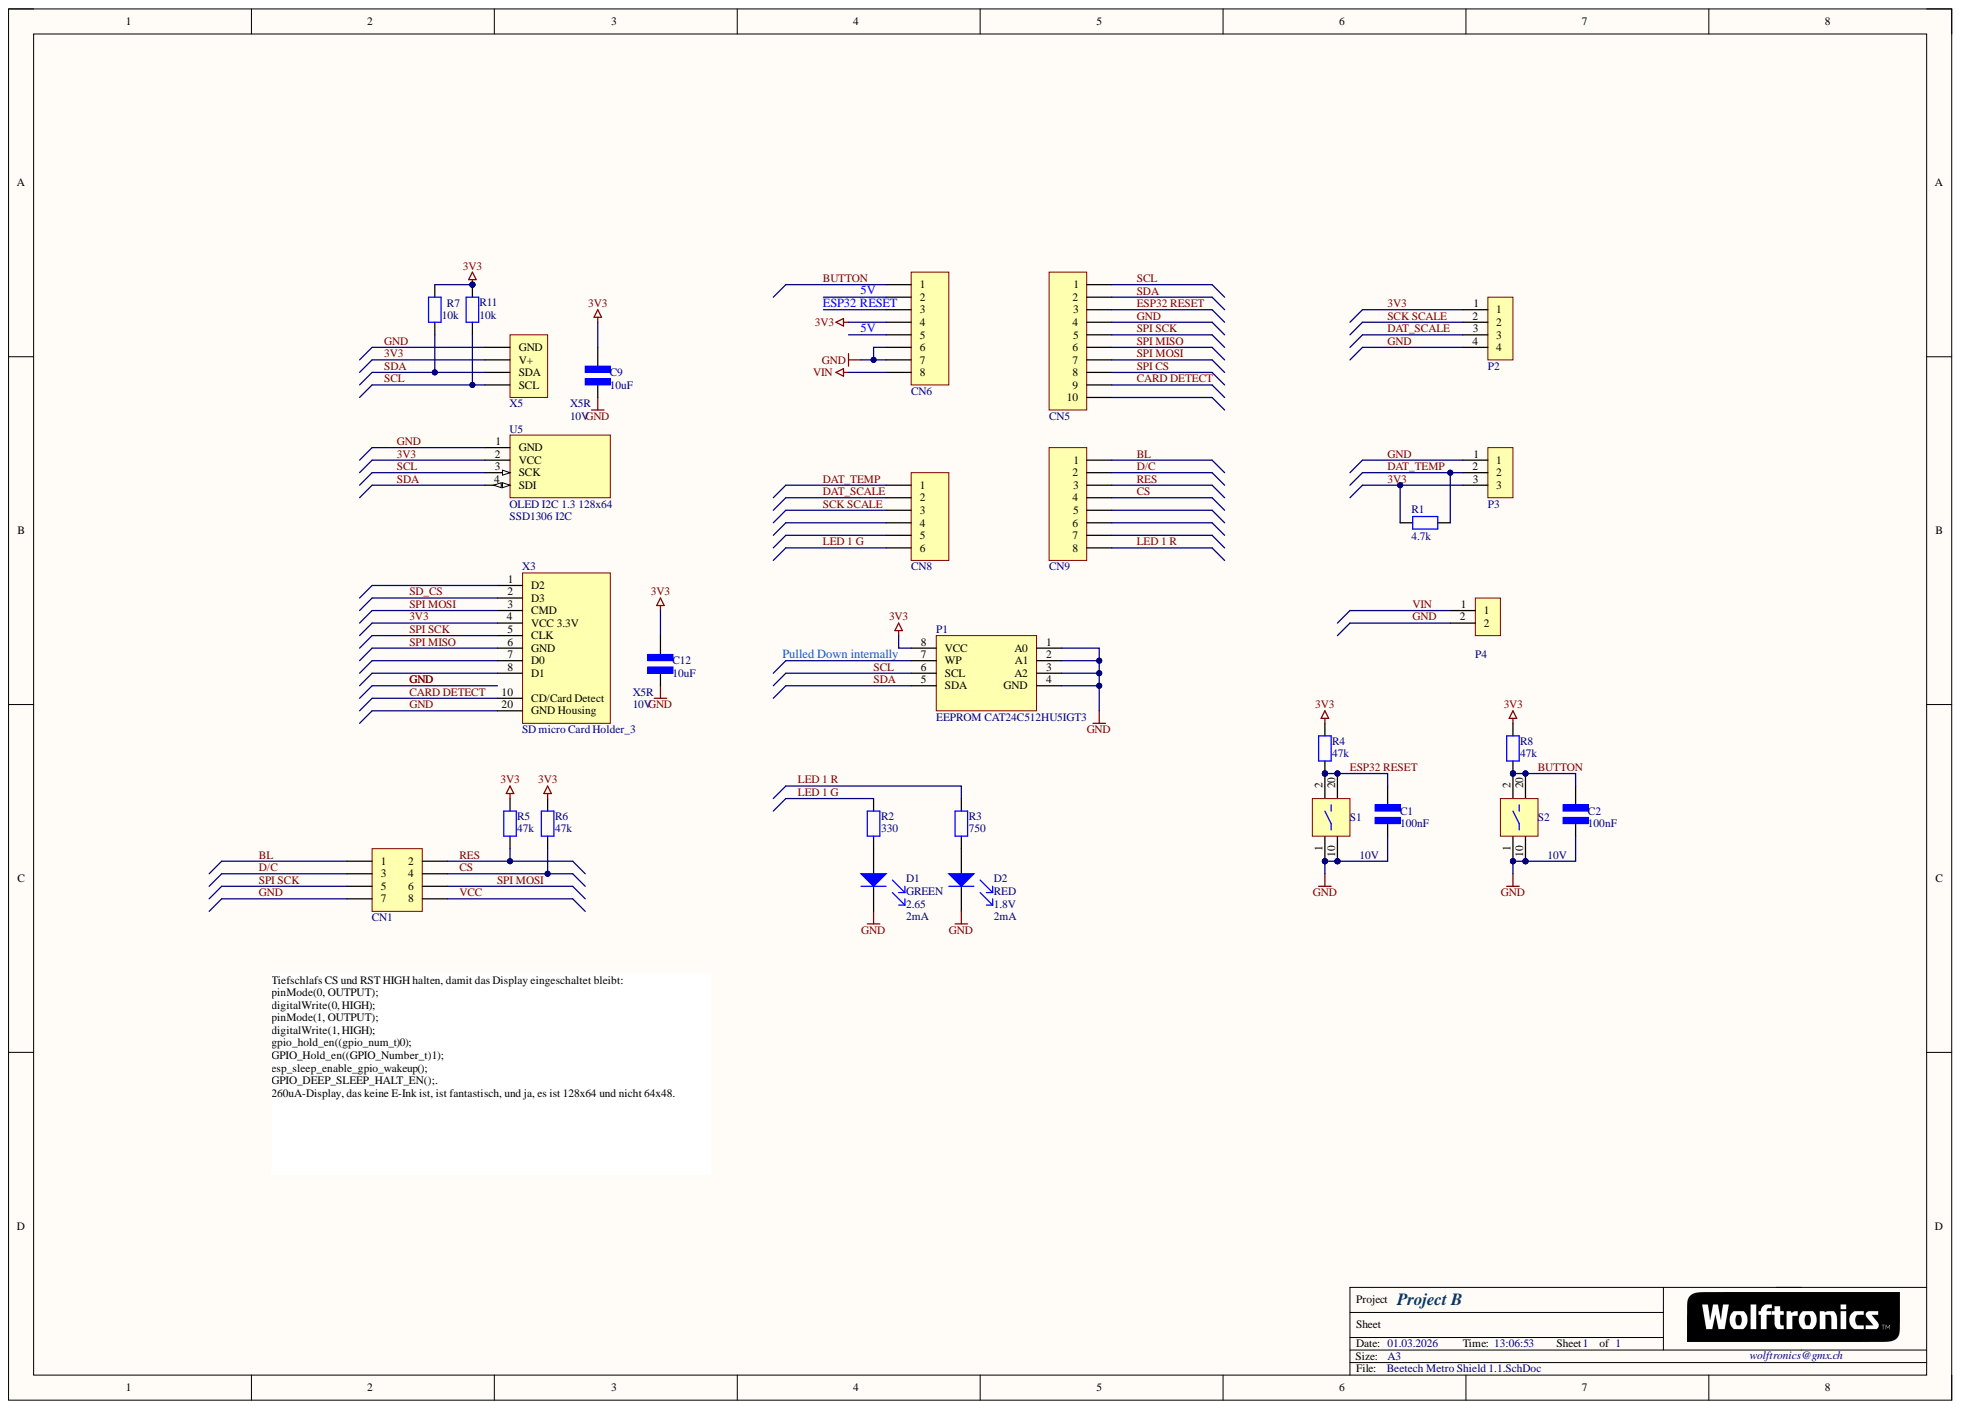
[picture p38: page 1]

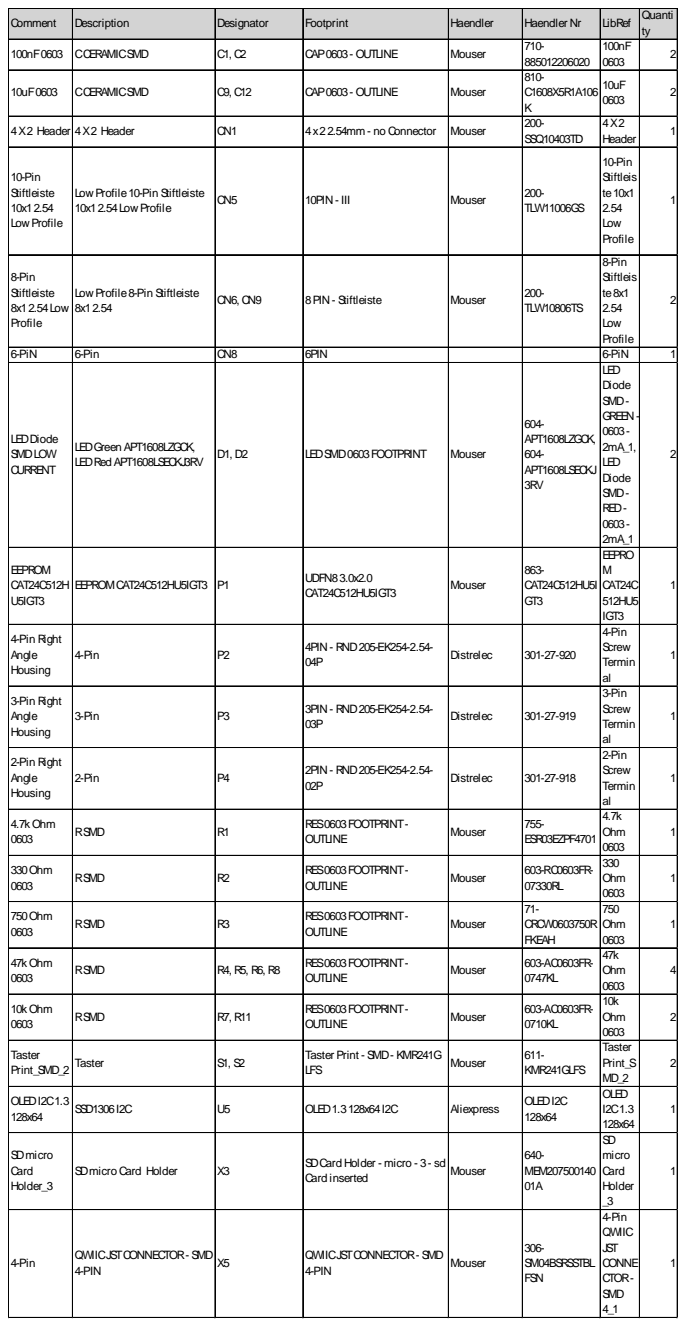
[picture p39: page 2]

Comment | Description | Designator | Footprint | Haendler | Haendler Nr | LibRef | Quanti ty

100nF0603 | CCERAMICSMD | C1, C2 | CAP0603- OUTLINE | Mouser | 710-885012206020 | 100nF 0603 | 2

10uF0603 | CCERAMICSMD | C9, C12 | CAP0603- OUTLINE | Mouser | 810-C1608X5R1A106 K | 10uF 0603 | 2

4X2 Header | 4X2 Header | CN1 | 4x22.54mm - no Connector | Mouser | 200-SSQ10403TD | 4X2 Header | 1

10-Pin Stiftleiste 10x12.54 Low Profile | Low Profile10-Pin Stiftleiste 10x12.54Low Profile | CN5 | 10PIN - III | Mouser | 200-TLW11006GS | 10-Pin Stiftleis te10x1 2.54 Low Profile | 1

8-Pin Stiftleiste 8x12.54Low Profile | Low Profile8-Pin Stiftleiste 8x12.54 | CN6, CN9 | 8PIN - Stiftleiste | Mouser | 200-TLW10806TS | 8-Pin Stiftleis te8x1 2.54 Low Profile | 2

6-PiN | 6-Pin | CN8 | 6PIN | | | 6-PiN | 1
LEDDiode SMDLOW CURRENT | LEDGreen APT1608LZGCK, LEDRed APT1608LSECKJ3RV | D1, D2 | LEDSMD0603FOOTPRINT | Mouser | 604-APT1608LZGCK, 604-APT1608LSECKJ 3RV | LED Diode SMD-GREEN -0603-2mA_1, LED Diode SMD-RED-0603-2mA_1 | 2

EEPROM CAT24C512H U5IGT3 | EEPROMCAT24C512HU5IGT3 | P1 | UDFN83.0x2.0 CAT24C512HU5IGT3 | Mouser | 863-CAT24C512HU5I GT3 | EEPRO M CAT24C 512HU5 IGT3 | 1

4-Pin Right Angle Housing | 4-Pin | P2 | 4PIN - RND205-EK254-2.54-04P | Distrelec | 301-27-920 | 4-Pin Screw Termin al | 1

3-Pin Right Angle Housing | 3-Pin | P3 | 3PIN - RND205-EK254-2.54-03P | Distrelec | 301-27-919 | 3-Pin Screw Termin al | 1

2-Pin Right Angle Housing | 2-Pin | P4 | 2PIN - RND205-EK254-2.54-02P | Distrelec | 301-27-918 | 2-Pin Screw Termin al | 1

4.7k Ohm 0603 | RSMD | R1 | RES0603FOOTPRINT-OUTLINE | Mouser | 755-ESR03EZPF4701 | 4.7k Ohm 0603 | 1

330Ohm 0603 | RSMD | R2 | RES0603FOOTPRINT-OUTLINE | Mouser | 603-RC0603FR-07330RL | 330 Ohm 0603 | 1

750Ohm 0603 | RSMD | R3 | RES0603FOOTPRINT-OUTLINE | Mouser | 71-CRCW0603750R FKEAH | 750 Ohm 0603 | 1

47k Ohm 0603 | RSMD | R4, R5, R6, R8 | RES0603FOOTPRINT-OUTLINE | Mouser | 603-AC0603FR-0747KL | 47k Ohm 0603 | 4

10k Ohm 0603 | RSMD | R7, R11 | RES0603FOOTPRINT-OUTLINE | Mouser | 603-AC0603FR-0710KL | 10k Ohm 0603 | 2

Taster Print_SMD_2 | Taster | S1, S2 | Taster Print - SMD- KMR241G LFS | Mouser | 611-KMR241GLFS | Taster Print_S MD_2 | 2

OLEDI2C1.3 128x64 | SSD1306I2C | U5 | OLED1.3128x64I2C | Aliexpress | OLEDI2C 128x64 | OLED I2C1.3 128x64 | 1

SDmicro Card Holder_3 | SDmicro Card Holder | X3 | SDCard Holder - micro - 3- sd Card inserted | Mouser | 640-MEM207500140 01A | SD micro Card Holder _3 | 1

4-Pin | QWIICJSTCONNECTOR- SMD 4-PIN | X5 | QWIICJSTCONNECTOR- SMD 4-PIN | Mouser | 306-SM04BSRSSTBL FSN | 4-Pin QWIIC JST CONNE CTOR-SMD 4_1 | 1
