al3xand3w0lf/BeeTech/ELECTRONIC_CAD/GSM_MKR_1400.pdf

S3 1

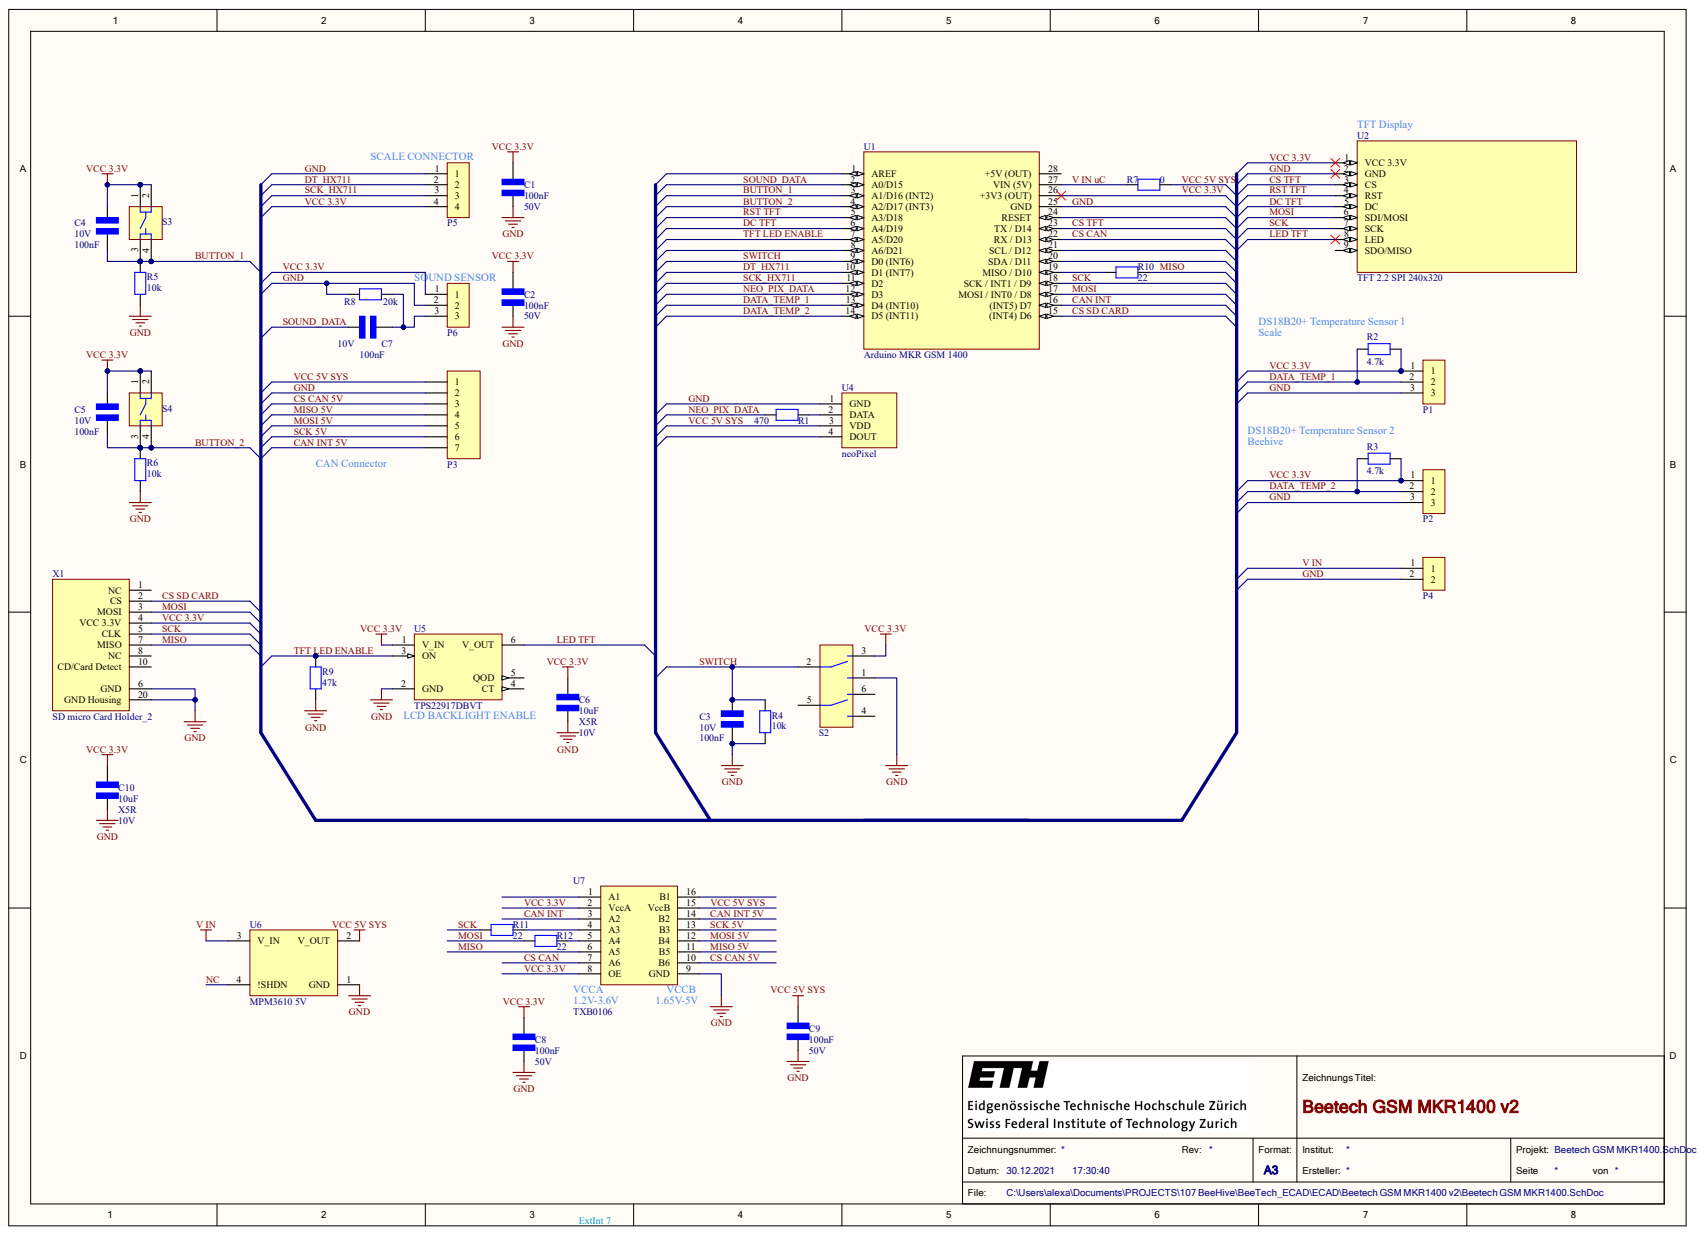
[picture p40: page 1]

TFT Display U2

Zeichnungs Titel: Beetech GSM MKR1400 v2

Zeichnungsnummer: * Rev: * Datum: 30.12.2021 17:30:40 | Format: A3 | Institut: * Ersteller: * | Projekt: Seite von * *

C:\Users\alexa\Documents\PROJECTS\107 BeeHive\BeeTech_ECAD\ECAD\Beetech GSM MKR1400 v2\Beetech GSM MKR1400.SchDoc
