al3xand3w0lf/BeeTech/ELECTRONIC_CAD/Nano Every 4.pdf

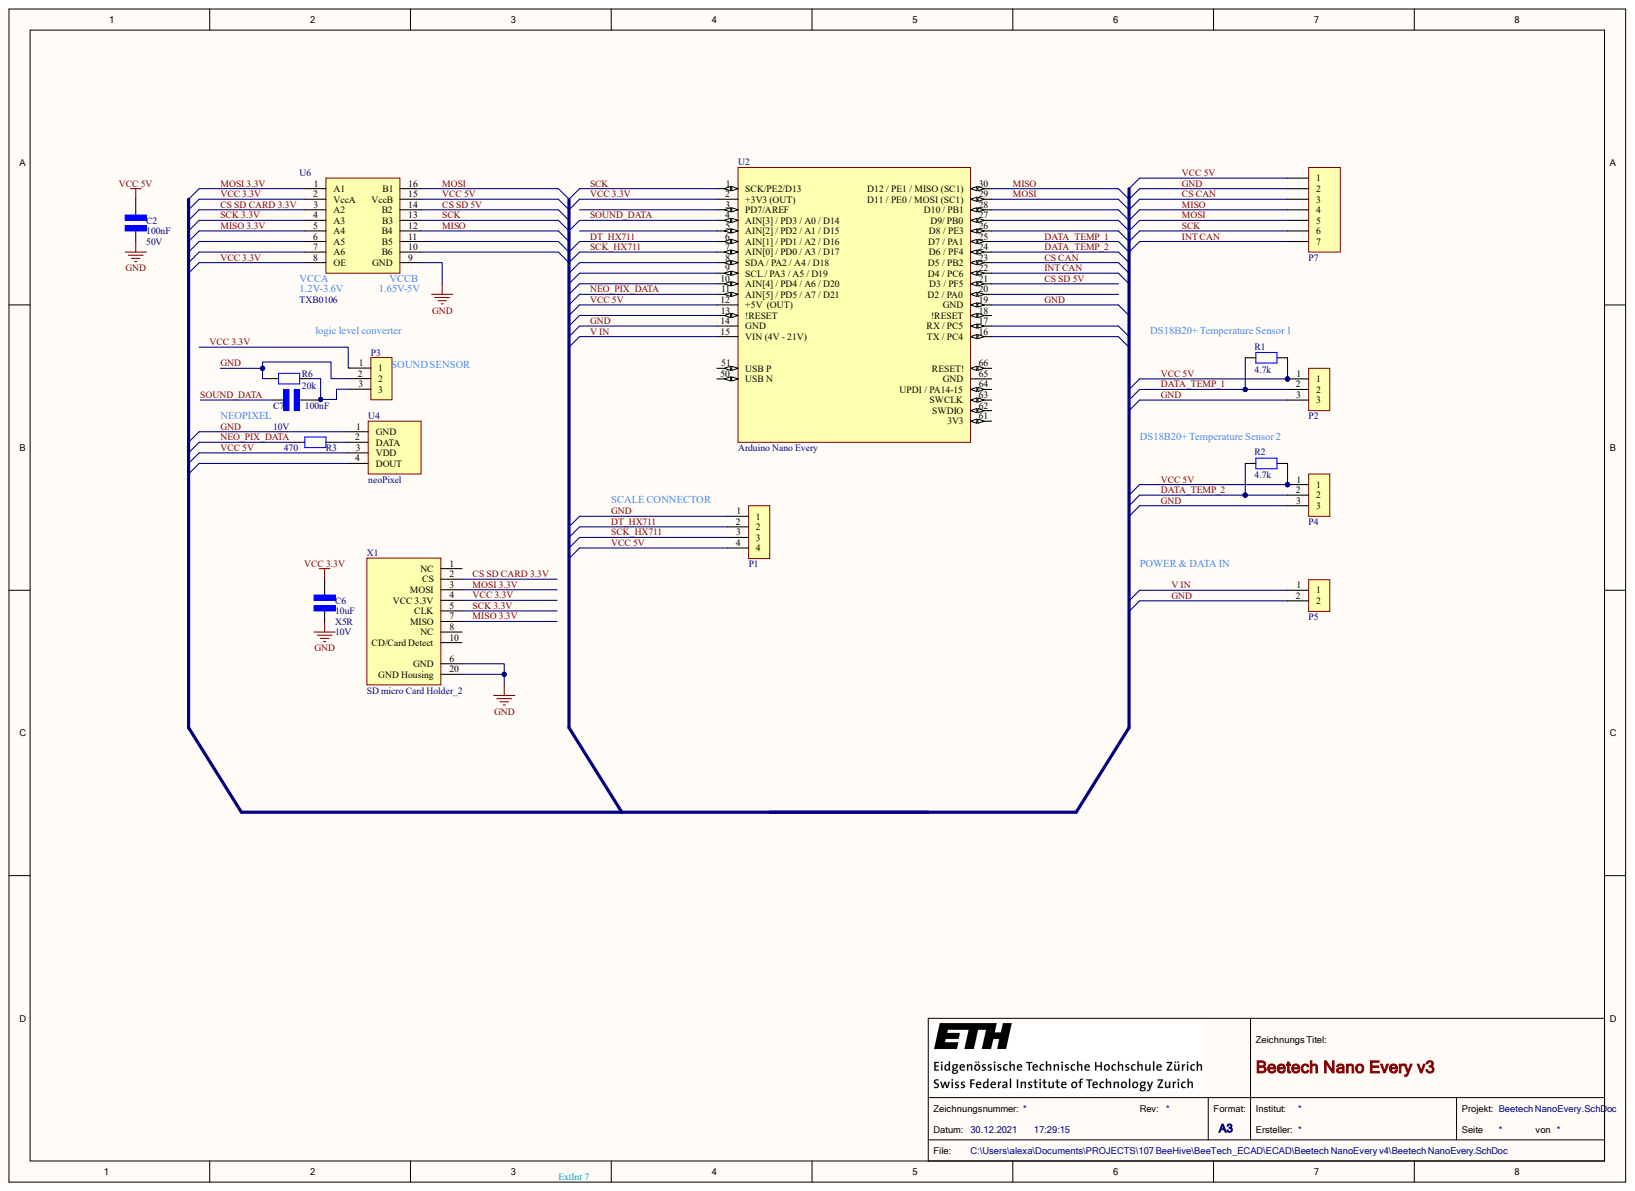
[picture p41: page 1]

Zeichnungs Titel: Beetech Nano Every v3

Zeichnungsnummer: * Rev: * Datum: 30.12.2021 17:29:15 | Format: A3 | Institut: * Ersteller: * | Projekt: Beetech NanoEvery.SchDoc Seite von * *

C:\Users\alexa\Documents\PROJECTS\107 BeeHive\BeeTech_ECAD\ECAD\Beetech NanoEvery v4\Beetech NanoEvery.SchDoc
