al3xand3w0lf/BeeTech/ELECTRONIC_CAD/voltageLevelsNanoBoard.pdf

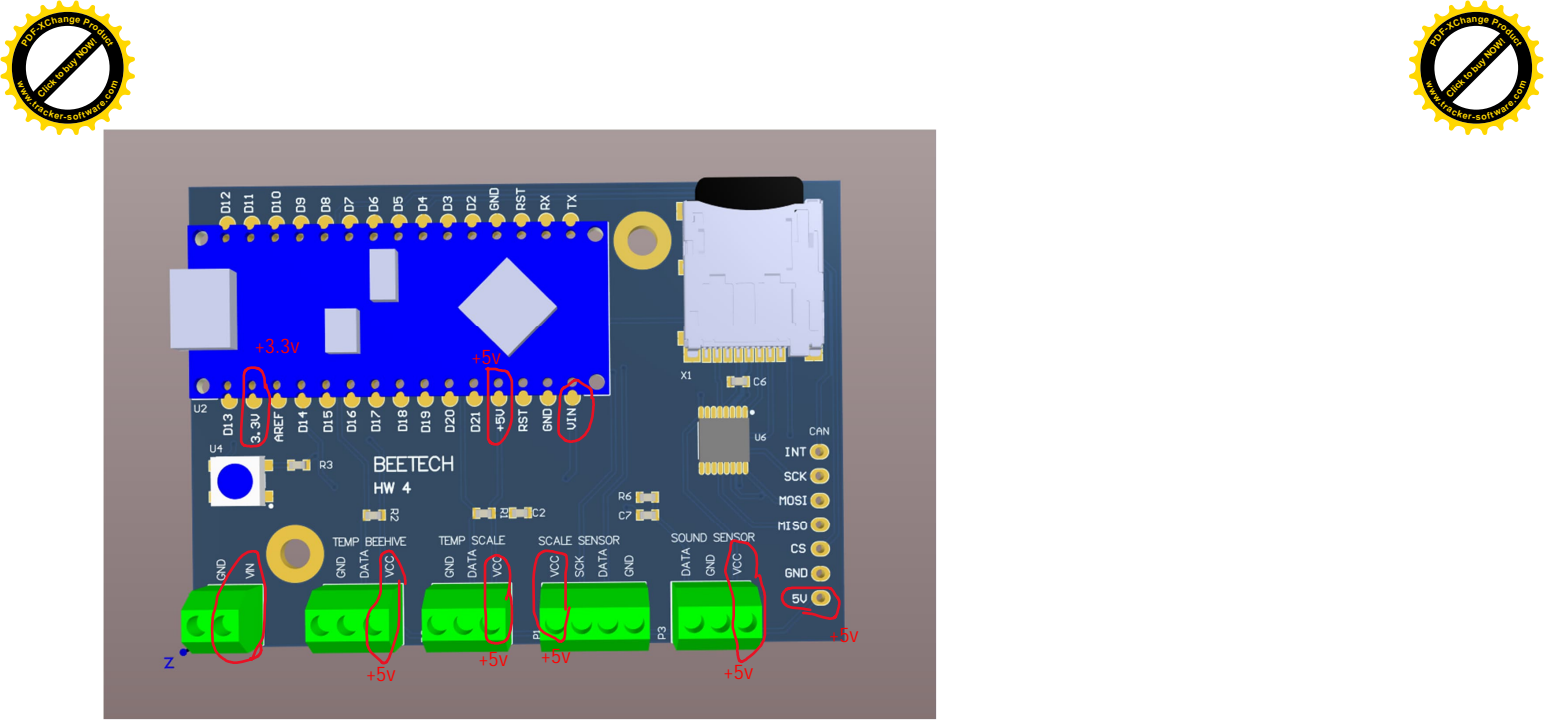
[picture p42: page 1]

PDF-XChange Product

Click to buy NOW!

www.tracker-software.com

www.tracker-software.com (http://www.tracker-software.com/buy-now)
