al3xand3w0lf/BeeTech/(list of files, drawings)

Other design files:
ELECTRONIC_CAD/ECAD/Beetech GSM MKR1400 v1/Beetech GSM MKR1400 v1.PrjPcb
ELECTRONIC_CAD/ECAD/Beetech GSM MKR1400 v1/Beetech GSM MKR1400.PcbDoc
ELECTRONIC_CAD/ECAD/Beetech GSM MKR1400 v1/Beetech GSM MKR1400.SchDoc
ELECTRONIC_CAD/ECAD/Beetech GSM MKR1400 v2/Bee Hive MasterBoard.SchDoc
ELECTRONIC_CAD/ECAD/Beetech GSM MKR1400 v2/Beetech GSM MKR1400 ver2.PrjPcb
ELECTRONIC_CAD/ECAD/Beetech GSM MKR1400 v2/Beetech GSM MKR1400.PcbDoc
ELECTRONIC_CAD/ECAD/Beetech GSM MKR1400 v2/Beetech GSM MKR1400.SchDoc
ELECTRONIC_CAD/ECAD/Beetech GSM MKR1400 v3/Beetech GSM MKR1400 ver3.PrjPcb
ELECTRONIC_CAD/ECAD/Beetech GSM MKR1400 v3/Beetech GSM MKR1400.PcbDoc
ELECTRONIC_CAD/ECAD/Beetech GSM MKR1400 v3/Beetech GSM MKR1400.SchDoc
ELECTRONIC_CAD/ECAD/Beetech Metro Shield 1.0/Beetech Metro Shield 1.0.PrjPcb
ELECTRONIC_CAD/ECAD/Beetech Metro Shield 1.1/Beetech Metro Shield 1.1.PrjPcb
ELECTRONIC_CAD/ECAD/Beetech Metro Shield 1.1/Beetech Metro Shield 1.1.SchDoc
ELECTRONIC_CAD/ECAD/Beetech Metro Shield 1.2/Beetech Metro Shield 1.2.PcbDoc
ELECTRONIC_CAD/ECAD/Beetech Metro Shield 1.2/Beetech Metro Shield 1.2.PrjPcb
ELECTRONIC_CAD/ECAD/Beetech Metro Shield 1.2/Beetech Metro Shield 1.2.SchDoc
ELECTRONIC_CAD/ECAD/Beetech Metro Shield 1.2/METRO Shield IO 1.0.SchDoc
ELECTRONIC_CAD/ECAD/Beetech NanoEvery v1/Bee Hive MainBoard PCB.PcbDoc
ELECTRONIC_CAD/ECAD/Beetech NanoEvery v1/Bee Hive MainBoard ver1.PrjPcb
ELECTRONIC_CAD/ECAD/Beetech NanoEvery v1/Bee Hive MainBoard.SchDoc
ELECTRONIC_CAD/ECAD/Beetech NanoEvery v2/Beetech NanoEvery v2.PrjPcb
ELECTRONIC_CAD/ECAD/Beetech NanoEvery v2/Beetech NanoEvery.PcbDoc
ELECTRONIC_CAD/ECAD/Beetech NanoEvery v2/Beetech NanoEvery.SchDoc
ELECTRONIC_CAD/ECAD/Beetech NanoEvery v3/Beetech NanoEvery v3.PrjPcb
ELECTRONIC_CAD/ECAD/Beetech NanoEvery v3/Beetech NanoEvery.PcbDoc
ELECTRONIC_CAD/ECAD/Beetech NanoEvery v3/Beetech NanoEvery.SchDoc
ELECTRONIC_CAD/ECAD/Beetech NanoEvery v4/Beetech NanoEvery.PcbDoc
ELECTRONIC_CAD/ECAD/Beetech NanoEvery v4/Beetech NanoEvery.SchDoc
ELECTRONIC_CAD/ECAD/Beetech NanoEvery v4/Beetech_NanoEvery v4.PrjPcb
ELECTRONIC_CAD/ECAD/Beetech Scale Board ver 1/Bee Hive Scale Board.PcbDoc
ELECTRONIC_CAD/ECAD/Beetech Scale Board ver 1/Bee Hive Scale Board.PrjPcb
ELECTRONIC_CAD/ECAD/Beetech Scale Board ver 1/Bee Hive Scale Board.SchDoc
ELECTRONIC_CAD/ECAD/Beetech Scale Board ver 2/Bee Hive Scale Board 2.PcbDoc
ELECTRONIC_CAD/ECAD/Beetech Scale Board ver 2/Bee Hive Scale Board 2.PrjPcb
ELECTRONIC_CAD/ECAD/Beetech Scale Board ver 2/Bee Hive Scale Board.SchDoc
ELECTRONIC_CAD/ECAD/Beetech Scale Board ver 3_0_DEF/Bee Hive Scale Board 3.PcbDoc
ELECTRONIC_CAD/ECAD/Beetech Scale Board ver 3_0_DEF/Bee Hive Scale Board 3.PrjPcb
ELECTRONIC_CAD/ECAD/Beetech Scale Board ver 3_0_DEF/Bee Hive Scale Board 3.SchDoc
ELECTRONIC_CAD/ECAD/Beetech Scale Board ver 3_1/Bee Hive Scale Board 3_1.PcbDoc
ELECTRONIC_CAD/ECAD/Beetech Scale Board ver 3_1/Bee Hive Scale Board 3_1.PrjPcb
ELECTRONIC_CAD/ECAD/Beetech Scale Board ver 3_1/Bee Hive Scale Board 3_1.SchDoc
ELECTRONIC_CAD/ECAD/NanoEvery Eagle/Imported (1) NANOEveryV3.0.PrjPcb/NANOEveryV3.0.PrjPcb
ELECTRONIC_CAD/ECAD/NanoEvery Eagle/Imported NANOEveryV3.0.PrjPcb/NANOEveryV3.0.PrjPcb
