al3xand3w0lf/BeeTech/(commit log)

2022-12-13 Initital Commit
    Initial Commit full repository
    [Antenna_.SLDPRT, BOM Beetech GSM MKR1400 v1.xlsx, BOM Beetech GSM MKR1400 ver2.xlsx, BOM Beetech NanoEvery v2.xlsx, BOM Beetech NanoEvery v3.xlsx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]
2025-02-28 Added Full E-CAD
    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
    [Antenna_.SLDPRT, BOM Beetech GSM MKR1400 v1.xlsx, BOM Beetech GSM MKR1400 ver2.xlsx, BOM Beetech NanoEvery v2.xlsx, BOM Beetech NanoEvery v3.xlsx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]
2025-02-28 added full blown ECAD
    [BOM Beetech GSM MKR1400 v1.xlsx, BOM Beetech GSM MKR1400 ver2.xlsx, BOM Beetech NanoEvery v2.xlsx, BOM Beetech NanoEvery v3.xlsx, Bee Hive MainBoard PCB.PcbDoc, Bee Hive MainBoard ver1.PrjPcb, Bee Hive MainBoard.SchDoc, Bee Hive MasterBoard.SchDoc]
2025-02-28 updated CAN Master Firmware
    [config.txt]
2026-02-08 Hallo V2
    [Beetech Metro Shield 1.0.GBL, Beetech Metro Shield 1.0.GBO, Beetech Metro Shield 1.0.GBP, Beetech Metro Shield 1.0.GBS, Beetech Metro Shield 1.0.GKO, Beetech Metro Shield 1.0.GTL, Beetech Metro Shield 1.0.GTO, Beetech Metro Shield 1.0.GTP]
2026-02-08 Add Beetech V2 ESP32 firmware with direct MySQL connection
    - New ESP32 Feather V2 based firmware using ESP32_MySQL library
    - Direct MySQL database connection (no HTTP intermediary)
    - Modular sketch structure: Database, Scale, Temperature, OLED, Terminal
    - SD card based configuration (config.txt)
    - Added test sketches for Database, Scale, and Temperature
    - Full documentation in README.md
    - Updated CLAUDE.md with V2 project structure
    [config.txt]
2026-02-08 Improve Database_Test with enhanced debugging features
    Add TCP pre-check, table structure inspection (DESCRIBE), row count,
    INSERT verification readback, timing measurements, WiFi reconnect,
    heap monitoring, interactive menu, and test data cleanup.
2026-02-08 added improved database_test script into main script
    [config.txt]
2026-02-09 Fix scale weight sign inversion and update gitignore
    - Fix HX711_Scale.ino: Negate get_units() result to correct sign inversion
    - Update .gitignore: Add History/ and Project Outputs for*/ patterns to exclude ECAD build artifacts
    - Add Beetech Metro Shield 1.1 design files
    The main BeetechV2_Scale firmware was displaying negative weights due to
    sign inversion in scale_read(). Test sketch Scale_Test worked correctly.
    Fixed by negating the result from scale.get_units(5).
    [Beetech Metro Shield 1.0.PcbDoc, Beetech Metro Shield 1.0.SchDoc, Beetech Metro Shield 1.1.PrjPcb, METRO Shield IO 1.0.SchDoc, PCB Arduino.SLDPRT, PCB Arduino.STEP, PCB.SLDPRT, PCB.STEP]
2026-02-09 Fix Scale main script. Fiully working now
    [config.txt]
2026-03-01 Added Meetro Shiel v1.1 - plus Schematic as PDF
    [Beetech Metro Shield 1.0.PcbDoc, Beetech Metro Shield 1.0.SchDoc, Beetech Metro Shield 1.1.PcbDoc, Beetech Metro Shield 1.1.SchDoc]
2026-03-01 Metro Shiel 1.1 added
    [Beetech Metro Shield 1.1.PcbDoc, Beetech Metro Shield 1.1.PrjPcb, Beetech Metro Shield 1.1.SchDoc, LCD Display 1,37 Zoll 1,37 Zoll Matrix LCD-Modul SPI-Schnittstelle AiP31567.SLDPRT]
2026-03-02 Startet with Metro shield Beetech Code
    LCD Works, SD Card fails
    [config.txt]
2026-03-03 Added SD Card Test codes
    [Beetech Metro Shield 1.1.SchDoc, Beetech Metro Shield 1.2.PcbDoc, Beetech Metro Shield 1.2.PrjPcb, Beetech Metro Shield 1.2.SchDoc, METRO Shield IO 1.0.SchDoc, PCB Arduino.SLDPRT, PCB Arduino.STEP, PCB.SLDPRT]
2026-03-03 Add SD card test suite and device modules
    Add a new SD Card test project (Testing/SD Card Test/BeetechV2_SD_CARD) with modular .ino files for SdCard, Database (MySQL), HX711 scale, DS18B20 temperature, ST7567 LCD, and Terminal interface. Include a screenshot asset and update Scale_Test pin mappings (HX711 DOUT/SCK -> GPIO1/7). Also tweak BeetechV2_Scale.ino header comment (ESP32-S3: 8MB flash, 2MB PSRAM) and rename several v1.0 files to v0.1 (no content changes). This introduces the testing scaffolding and drivers needed to load config from SD, read sensors, display data and upload to MySQL.
2026-03-03 Add BeehiveScale sketch, tests and docs update
    Add a new BeehiveScale.ino (ESP32 S3) implementing HX711 weight sampling, EEPROM tare persistence, OLED display, WiFi + HTTP POST to Flask, and deep-sleep power saving. Also add simple test sketches: DS18B20_test and I2C_Scanner. Move multiple SD Card Test sketches into a new "other Boards" subfolder (file renames). Update Scale_Test: add continuous output toggle (p), show raw value, and change default HX711 pins. Update Temperature_Test DS18B20 pin for the current V2 hardware. Revise PROGRAMMING/CLAUDE.md to document current V2 hardware (ESP32-S3), Arduino IDE settings, library matrix, pinouts for both V2 variants, configuration, and testing no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
2026-03-04 waegezelle halter hinzu gefügt - Beetech Metro Shield 1.2 überarbeitet
    [Beetech Metro Shield 1.2.PcbDoc, waegezelle halter.3mf, waegezelle halter.SLDPRT, waegezelle halter.STEP]
2026-03-05 Remove tracked files that match .gitignore patterns
    Stop tracking Altium output directories (Project Outputs for*/,
    History/, logs, etc.) that were committed before .gitignore was added.
    Files are removed from the index only — local copies are untouched.
    This fixes dirty working tree and pull conflicts caused by these files.
    [Bee Hive Scale Board 2.GBL, Bee Hive Scale Board 2.GBO, Bee Hive Scale Board 2.GBP, Bee Hive Scale Board 2.GBS, Bee Hive Scale Board 2.GKO, Bee Hive Scale Board 2.GTL, Bee Hive Scale Board 2.GTO, Bee Hive Scale Board 2.GTP]
2026-03-05 Update Altium projects, ETH docs, and add SD Card test sketches
    - Update Altium project files (.PrjPcb, .PrjPcbStructure, .OutJob) for
    GSM MKR1400 v1, NanoEvery v1/v2/v3, Scale Board v3_1, Eagle NanoEvery
    - Update MECHANIC_CAD LoadCellFrame2.STEP
    - Update Beetech ETH documentation and Arduino sketches
    - Update README.md, LICENSE, Notes on Parts.txt
    - Add new SD Card test sketches for multiple boards
2026-03-05 Improve BeetechV2_Scale: fix scale sign, non-blocking WiFi, redesign LCD
    - Fix HX711 negative weight by removing sign negation in scale_read()
    - Add short WiFi timeout (5s) at startup so boot is not blocked
    - WiFi auto-reconnect enabled, full reconnect on upload
    - Skip DB connection attempt when WiFi is unavailable
    - Force first sensor read immediately after boot
    - Redesign all LCD screens with larger fonts and full display usage
    - Add lcd_showBootStep() for clear per-step boot status
    - Fix weight/kg collision in data display
    [BeetechV2_Scale.ino, Database.ino, HX711_Scale.ino, ST7567_LCD.ino]
2026-03-06 ECAD ver 1.2
    [Beetech Metro Shield 1.2.PcbDoc, Beetech Metro Shield 1.2.SchDoc]
2026-03-07 Add deep sleep mode, persistent tare offset, and LCD hold for BeetechV2_Scale_Beehive
    - Implement ESP32 deep sleep: measure + upload + sleep for upload_interval seconds
    - Store tare offset persistently in /tare_offset.txt on SD card (survives power loss)
    - Hold LCD GPIO pins during deep sleep so display stays on showing last measurement
    - Add 'saveoffset' terminal command to persist tare offset after tareing
    - Rename main production sketch to BeetechV2_Scale_Beehive, move old version to Testing/
    - Remove obsolete v0.1 (Feather V2) sketch
    - Add terminal_cli.md with full CLI reference and setup workflows
    - Update CLAUDE.md with operating modes, tare offset docs, pin table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
    [config.txt]
2026-03-08 Add station name and number to LCD data screen
    Show station header (#number name) at top of measurement display.
    Weight font reduced from logisoso32 to logisoso24 to fit new layout.
    [Beetech Metro Shield 1.2.PrjPcb]
2026-03-22 Fix SD card init failure after deep sleep wake-up
    - Add retry logic (3 attempts) with full SPI bus re-init between retries
    - Use SPI.begin with SS=-1 to avoid hardware SS conflict with SD library
    - Deselect LCD CS before SD init to prevent SPI bus contention
    - Use conservative 4 MHz SPI clock for post-sleep stability
    - Add 10ms delay after GPIO hold release for pin stabilization
    [BeetechV2_Scale_Beehive.ino, SdCard.ino]
2026-03-22 Fix SD card warm-reset failure with CMD0 reset, NVS fallback, and proper shutdown
    - Send manual CMD0 (GO_IDLE_STATE) with CRC 0x95 before SD.begin() to force
    card out of leftover SPI state after deep sleep warm reset
    - Enable internal pull-up on MISO (GPIO13) so SD driver doesn't stall
    - Release GPIO hold on SD CS pin after deep sleep wake-up
    - Properly unmount SD card (SD.end + SPI.end) before entering deep sleep
    - Add NVS (Non-Volatile Storage) config fallback: cache config to ESP32
    flash on successful SD load, use as fallback when SD card fails
    - Auto-restart after 3s on config failure instead of hanging in while(1)
    - Remove duplicate serial log messages for scale and temperature init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
    [BeetechV2_Scale_Beehive.ino, SdCard.ino]
2026-03-22 Add firmware version, SD card CMD0 per retry, NVS write optimization
    - Add firmware version define (v1.0.0) and display on boot
    - Move CMD0 reset into retry loop so each attempt gets a full SPI+CMD0 reset
    - Only write config to NVS when values actually changed (preserve flash life)
    [BeetechV2_Scale_Beehive.ino, SdCard.ino]
