al3xand3w0lf/BeeTech/(notices)

Notices in the files:
ELECTRONIC_CAD/ECAD/NanoEvery Eagle/NANOEveryV3.0.brd:
Copyright (c) 2016-2017 Arduino LLC. All right reserved. EAGLE Design Rules
parts and their libraries:
Arduino-utility: This work is licensed under a Creative Commons Attribution-ShareAlike 4.0 International License.
Arduino-supply: Copyright (c) 2016-2017 Arduino LLC. All right reserved.
